phoenix9668/RFID_CC1101_433MHz_V2/Doc/PCB板载天线问题总结/微信图片_20250408164857.jpg

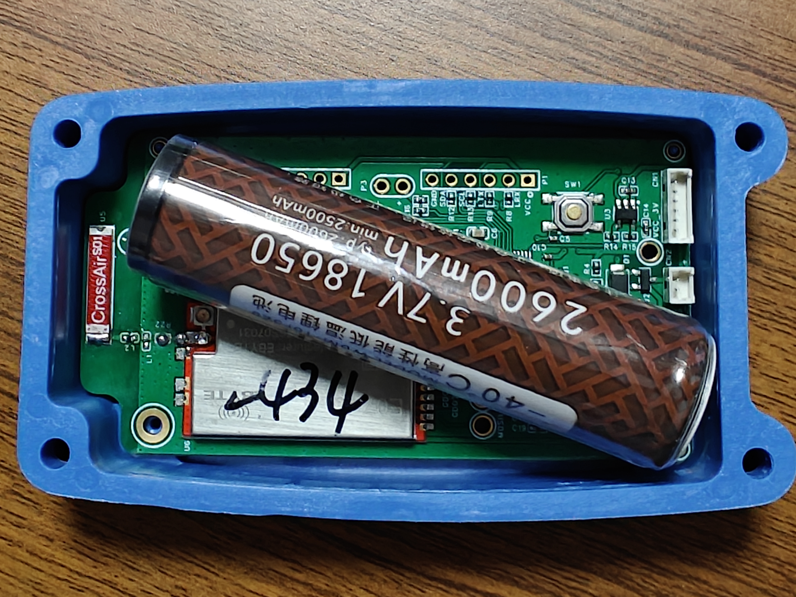
Doc/PCB板载天线问题总结/微信图片_20250408164857.jpg
