phoenix9668/RFID_CC1101_433MHz_V2/README.md

# RFID_CC1101_433MHz_V2
 upgrade of RFID_CC1101_433MHz program, use STM32L051C8, use HAL and LL Library, upgrade CC1101 Transceiver function (bytes upon 64).

## crc module configure as follow

Snipaste_2022-01-21_17-23-00

[](https://stackoverflow.com/questions/39646441/how-to-set-stm32-to-generate-standard-crc32)
