phoenix9668/RFID_CC1101_433MHz_V2/Tools/adxl362_pc/README.md

# ADXL362 PC algorithm runner

This harness compiles the production `Core/Src/adxl362_behavior.c` and
`Core/Inc/adxl362.h` directly. The firmware algorithm and its data structures
are not copied or modified. PC-only headers replace STM32 peripherals, and
`src/main.c` converts decoded CSV `x,y,z` samples back into the ADXL362 FIFO
byte format expected by `ADXL362FifoProcess()`.

## Data contract

- CSV header must contain `x`, `y`, and `z`.
- Values must be integer ADXL362 12-bit samples in `-2048..2047`.
- Sampling rate is 25 Hz.
- One firmware FIFO call consumes 150 samples (6 seconds / 900 bytes).
- An incomplete final 150-sample block is reported and ignored.
- CSV fields containing embedded commas are not supported by this small runner.

## Build and run

```sh
cd Tools/adxl362_pc
make
./build/adxl362_pc ../../Doc/data/chuanxi.csv result.csv
```

Use the firmware's `rfid_printf` diagnostics:

```sh
./build/adxl362_pc --verbose ../../Doc/data/chuanxi.csv result.csv
```

Build with AddressSanitizer and UndefinedBehaviorSanitizer:

```sh
make sanitize
./build-sanitize/adxl362_pc ../../Doc/data/chuanxi.csv result.csv
```

The output preserves each processed input row and appends a `behavior`
column. The behavior number is repeated for the corresponding 25 samples:

- `0`: initial delay
- `1`: rest
- `2`: ingestion
- `3`: movement
- `4`: climb
- `5`: ruminate
- `6`: other
- `7`: breath

## Windows PowerShell

With native MinGW-w64 GCC on PATH, run from the repository root:

```powershell
New-Item -ItemType Directory -Force build/adxl362-pc
gcc -std=c11 -O2 -Wall -Wextra -ITools/adxl362_pc/include -ICore/Inc -D_Original_Data_Algorithm=1 -DADXL362_PC_RUNNER=1 Tools/adxl362_pc/src/main.c Tools/adxl362_pc/src/pc_platform.c Core/Src/adxl362_behavior.c -lm -o build/adxl362-pc/adxl362_pc.exe
./build/adxl362-pc/adxl362_pc.exe Doc/data/chuanxi.csv build/adxl362-pc/chuanxi.csv
```

`pc_getline.h` supplies the line reader on Windows; POSIX builds continue using
the system `getline`. Some older MinGW runtimes cannot open non-ASCII argument
paths. Copy such fixtures to an ASCII filename under `build/`, verify the copy's
SHA256 matches the source, and pass that path to the runner.

Test empty input, line endings, long lines and a final line without a newline:

```sh
make test
```

Or, from the repository root in PowerShell after creating the build directory:

```powershell
gcc -std=c11 -Wall -Wextra -Werror -ITools/adxl362_pc/include Tools/adxl362_pc/tests/test_pc_getline.c -o build/adxl362-pc/test_pc_getline.exe
./build/adxl362-pc/test_pc_getline.exe build/adxl362-pc/test_pc_getline.tmp
```
