phoenix9668/RFID_CC1101_433MHz_V2/Drivers/ADI/no-OS/README.md

# Analog Devices no-OS Snapshot

Imported from `analogdevicesinc/no-OS` commit
`0c4ef5cd278555ba4d426b35f87f30102460361f`.

Vendored files:

- `drivers/accel/adxl362/adxl362.c`
- `drivers/accel/adxl362/adxl362.h`
- `include/no_os_spi.h`
- `include/no_os_alloc.h`

Project-specific compatibility implementations live in `Core/Src`:

- `no_os_spi_stm32l0.c`
- `no_os_alloc.c`
