phoenix9668/RFID_CC1101_433MHz_V2/Doc/Contracts/购销合同_RFID_CC1101_433MHz_V3.8(盖章).pdf

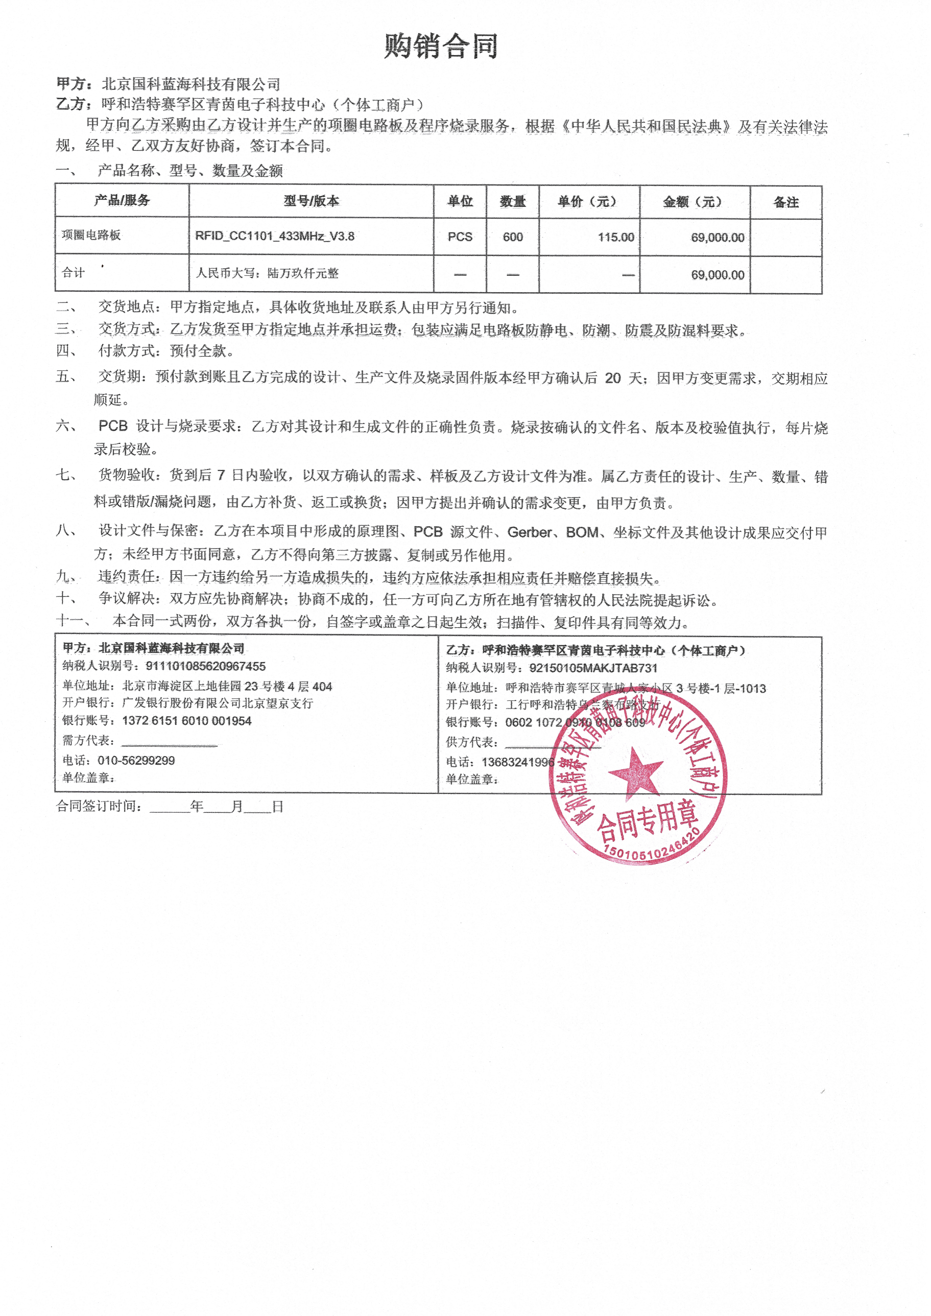
[picture p16: page 1]
