phoenix9668/RFID_CC1101_433MHz_V2/Doc/MATLAB/climb_analysis/视频3.png

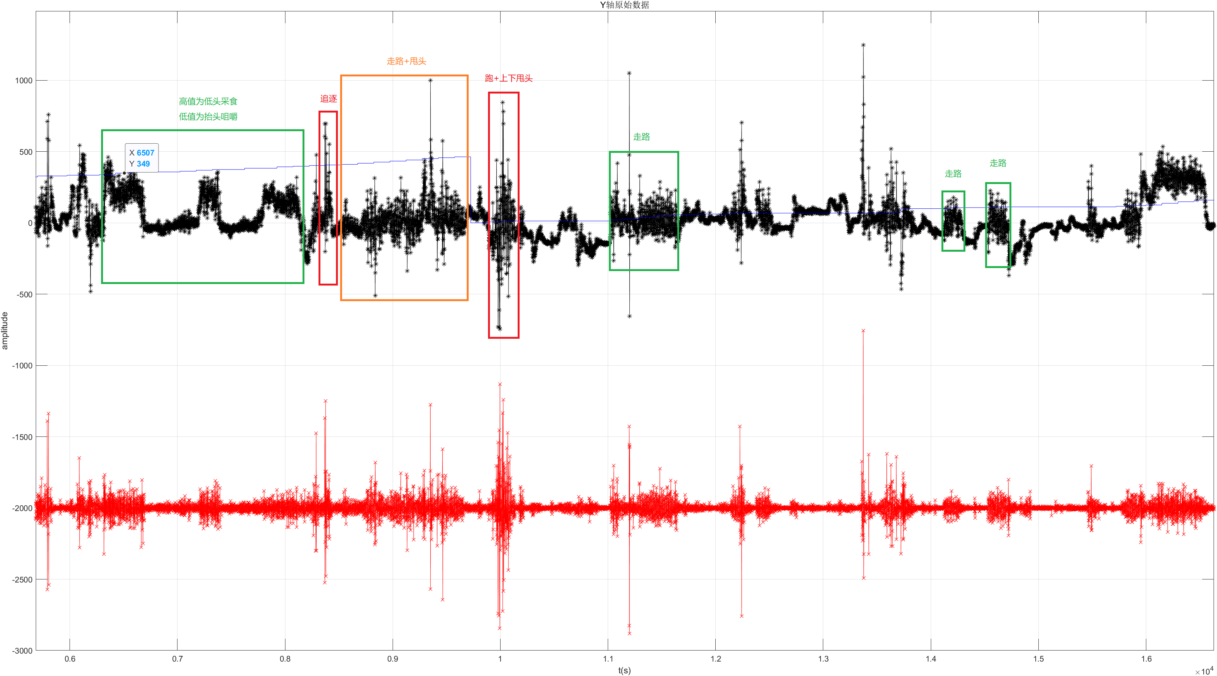
Doc/MATLAB/climb_analysis/视频3.png
