phoenix9668/RFID_CC1101_433MHz_V2/Doc/Picture/FIFOread总时序.PNG

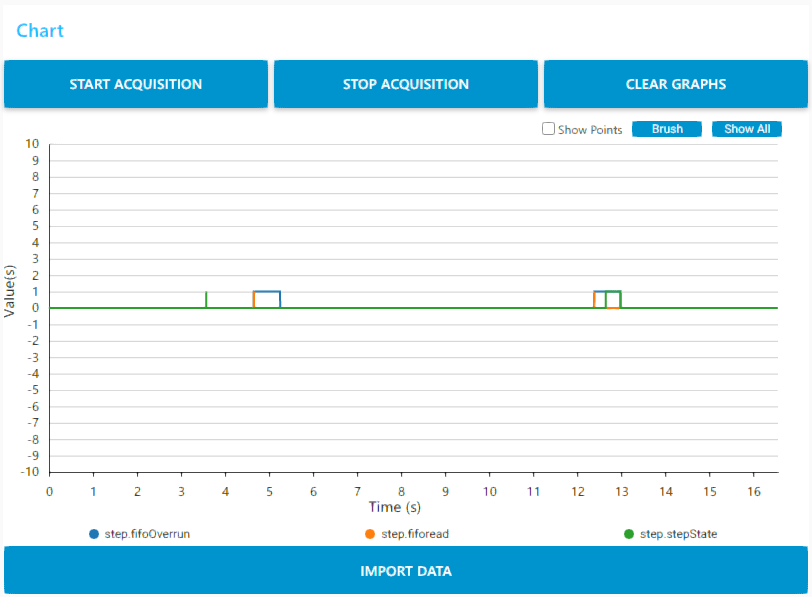
Doc/Picture/FIFOread总时序.PNG
