phoenix9668/RFID_CC1101_433MHz_V2/Doc/Picture/FIFOread总时序终点.png

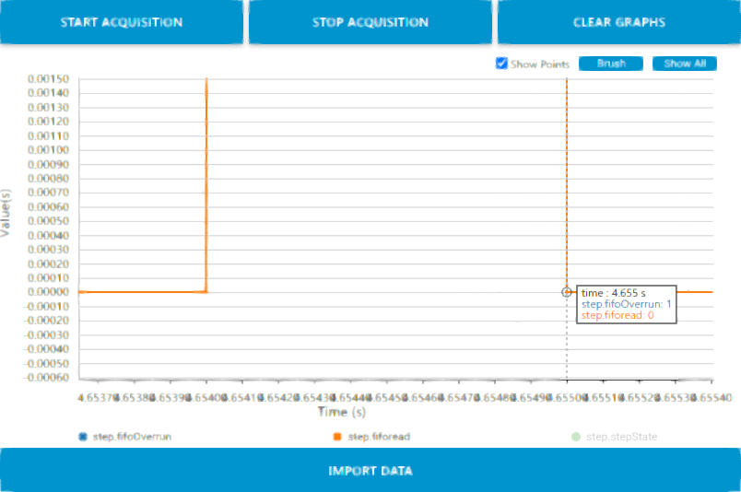
Doc/Picture/FIFOread总时序终点.png
