phoenix9668/RFID_CC1101_433MHz_V2/Doc/Picture/power.png

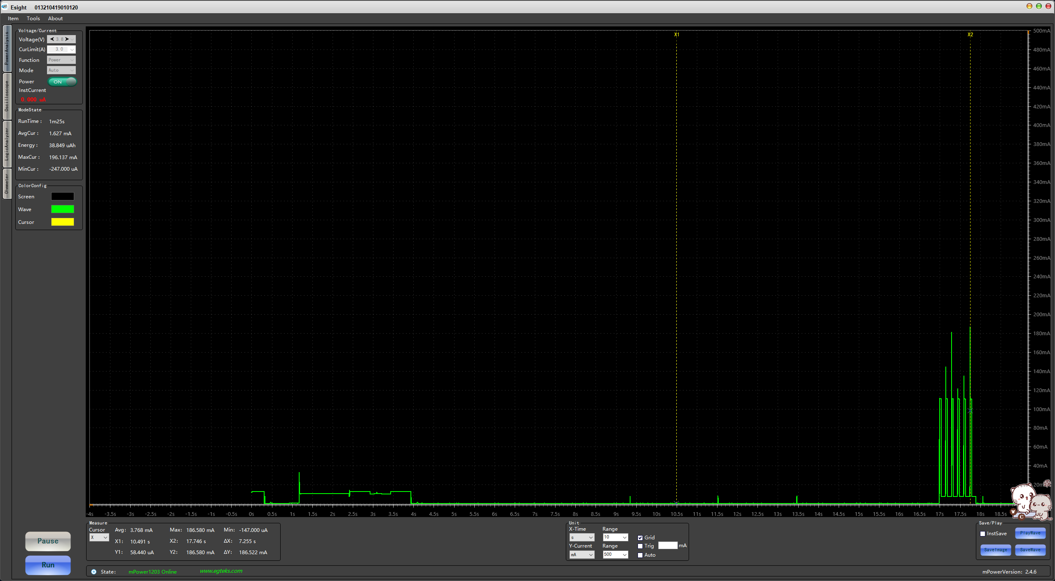
Doc/Picture/power.png
