phoenix9668/RFID_CC1101_433MHz_V2/Doc/Picture/tui1.png

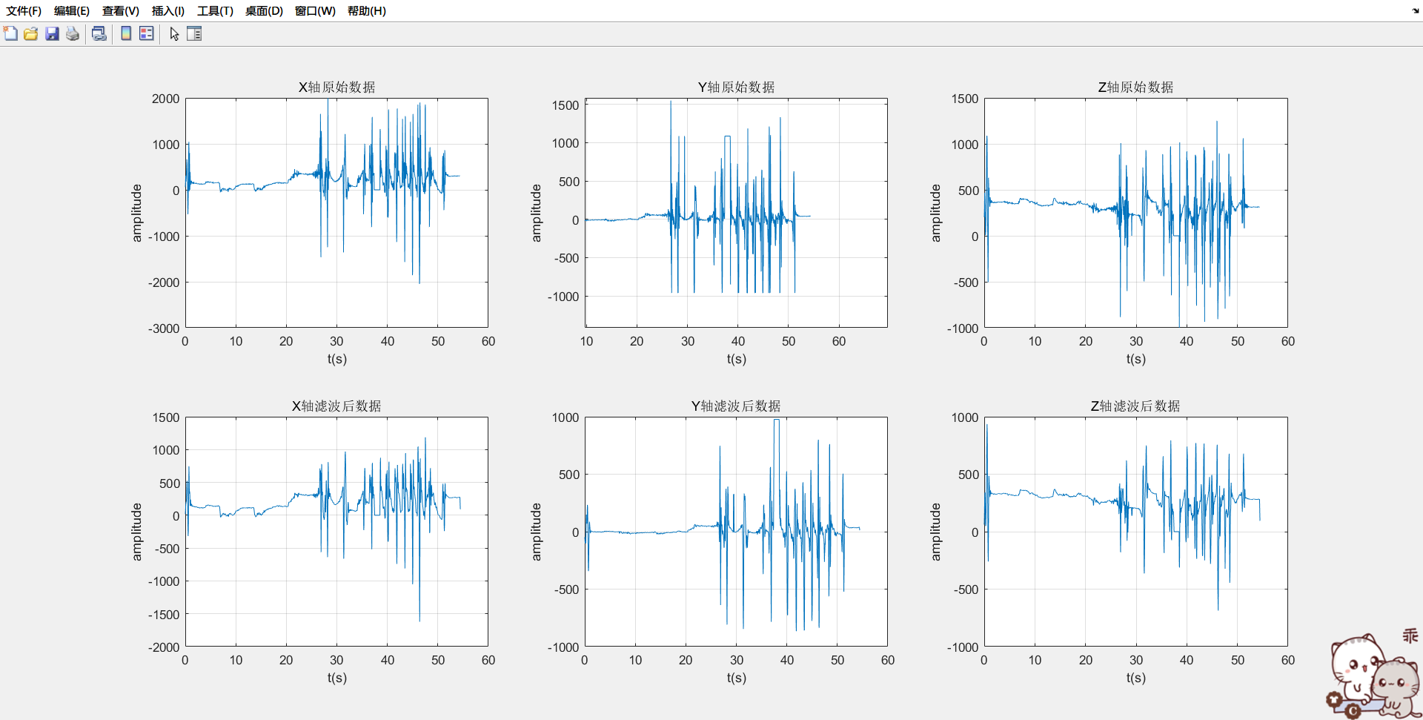
Doc/Picture/tui1.png
