phoenix9668/RFID_CC1101_433MHz_V2/Doc/Picture/发情算法计算时长.bmp

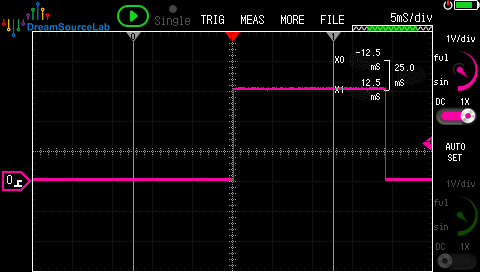
Doc/Picture/发情算法计算时长.bmp
