phoenix9668/RFID_CC1101_433MHz_V2/PCB/RFID_CC1101_433MHz_V3.8/BOM_RFID_CC1101_433MHz(2025.8.18)_RFID_CC1101_433MHz(2025.8.18)_2026-09-21.xlsx

No. | Quantity | Comment | Designator | Footprint | Value | Manufacturer Part | Manufacturer | Supplier Part | Supplier | LCSC Stock | LCSC Price
1 | 1 | BH-16340 | BT1 | BATTERY-SMD_16340
2 | 2 | 10pF | C1,C2 | C0402 | 10pF | CC0402FRNPO9BN100 | YAGEO(国巨) | C513681 | LCSC | 6097 | 0.0428
3 | 2 | 18pF | C3,C4 | C0402 | 18pF | CC0402FRNPO9BN180 | YAGEO(国巨) | C541431 | LCSC | 1167 | 0.0272
4 | 9 | 100nF | C5,C7,C9,C10,C11,C12,C17,C18,C21 | C0402 | 100nF | GRM155R71H104KE14D | muRata(村田) | C77020 | LCSC | 29641 | 0.0595
5 | 3 | 10uF | C6,C15,C16 | C0603 | 10uF | GRM188R61E106MA73D | muRata(村田) | C91606 | LCSC | 100662 | 0.5319
6 | 5 | 1uF | C8,C13,C14,C19,C20 | C0402 | 1uF | GRM155R6YA105KE11D | muRata(村田) | C361059 | LCSC | 1040 | 0.296
7 | 1 | HC-1.25-6A | CN1 | CONN-TH_6P-P1.25_HCTL_HC-1.25-6A |  | HC-1.25-6A | HCTL(华灿天禄) | C2845524 | LCSC | 1566 | 0.4415
8 | 1 | A1251WV-2P | CN2 | CONN-TH_2P-P1.25_A1251WV-2P |  | A1251WV-2P | CJT(长江连接器) | C225090 | LCSC
9 | 1 | SS24A | D1 | SMA_L4.2-W2.6-LS5.1-RD |  | SS24A | FUXINSEMI(富芯森美) | C842786 | LCSC | 366 | 0.135
10 | 1 | 27nH | L1 | L0402-RD | 27nH | LQG15HS27NJ02D | muRata(村田) | C12669 | LCSC | 3741 | 0.1162
11 | 1 | 47nH | L2 | L0402 | 47nH | LQG15HS47NJ02D | muRata(村田) | C97998 | LCSC | 1121 | 0.1504
12 | 2 | XL-1608SYGC-06 | LED1,LED2 | LED0603-RD_GREEN |  | XL-1608SYGC-06 | XINGLIGHT(成兴光) | C965805 | LCSC | 6263 | 0.0438
13 | 1 | XL-1608SURC-06 | LED3 | LED0603-RD_RED |  | XL-1608SURC-06 | XINGLIGHT(成兴光) | C965799 | LCSC | 41227 | 0.0231
14 | 1 | A2541HWV-6P | P1 | HDR-TH_6P-P2.54-V-F |  | A2541HWV-6P | CJT(长江连接器) | C2897443 | LCSC
15 | 1 | LBC0060B | P2 | LBC0060B
16 | 2 | S8050 | Q1,Q4 | SOT-23-3_L2.9-W1.3-P1.90-LS2.4-BR |  | S8050 | GOODWORK(固得沃克) | C909746 | LCSC | 2008 | 0.0726
17 | 2 | YJL2301C | Q2,Q3 | SOT-23-3_L2.9-W1.3-P1.90-LS2.4-BR |  | YJL2301C | YANGJIE(扬杰) | C699310 | LCSC | 143 | 0.2993
18 | 1 | 390Ω | R1 | R0402 | 390Ω | RC0402FR-07390RL | YAGEO(国巨) | C137997 | LCSC | 18559 | 0.0071
19 | 4 | 10kΩ | R2,R4,R12,R15 | R0402 | 10kΩ | RC0402FR-0710KL | YAGEO(国巨) | C60490 | LCSC | 54548 | 0.0197
20 | 3 | 1kΩ | R3,R14,R17 | R0402 | 1kΩ | RC0402FR-071KL | YAGEO(国巨) | C106235 | LCSC | 26273 | 0.0266
21 | 2 | 10MΩ | R5,R6 | R0402 | 10MΩ | RC0402FR-0710ML | YAGEO(国巨) | C138067 | LCSC | 0 | 0.0102
22 | 2 | 0Ω | R7,R18 | R0402 | 0Ω | RC0402FR-070RL | YAGEO(国巨) | C106231 | LCSC | 7794 | 0.0215
23 | 4 | 33Ω | R8,R9,R10,R11 | R0402 | 33Ω | RC0402FR-0733RL | YAGEO(国巨) | C138002 | LCSC | 80943 | 0.0217
24 | 1 | 1.2kΩ | R13 | R0402 | 1.2kΩ | RC0402FR-071K2L | YAGEO(国巨) | C138040 | LCSC | 2224 | 0.0248
25 | 1 | 100kΩ | R16 | R0402 | 100kΩ | RC0402FR-07100KL | YAGEO(国巨) | C60491 | LCSC | 83428 | 0.0161
26 | 1 | TS-1088R-02526 | SW2 | SW-SMD_L3.9-W3.0-P4.45 |  | TS-1088R-02526 | XUNPU(讯普) | C455281 | LCSC | 3137 | 0.4489
27 | 1 | M2铜柱 | TP1 | th_bd4.0-d2.0 |  | M2铜柱 |  | C9900004684 | LCSC
28 | 3 | M2铜柱 | TP2,TP3,TP4 | TH_BD4.0-D2.0_1 |  | M2铜柱 |  | C9900004684 | LCSC
29 | 16 | Test-Point | TP5,TP6,TP7,TP8,TP9,TP10,TP11,TP12,TP13,TP14,TP15,TP16,TP17,TP18,TP19,TP20 | Test-Point-0.5mm
30 | 1 | STM32L051C8T6 | U1 | LQFP-48_L7.0-W7.0-P0.50-LS9.0-BL |  | STM32L051C8T6 | ST(意法半导体) | C110878 | LCSC | 11621 | 10.47
31 | 1 | ADXL362BCCZ-RL | U2 | LGA-16_L3.0-W3.0-P0.50-BL |  | ADXL362BCCZ-RL | ADI(亚德诺) | C59641 | LCSC | 0 | 100.5648
32 | 1 | LP5907MFX-3.0/NOPB | U3 | SOT-23-5_L3.0-W1.7-P0.95-LS2.8-BL |  | LP5907MFX-3.0/NOPB | TI(德州仪器) | C475492 | LCSC | 2242 | 1.9955
33 | 1 | TP4056-42-ESOP8 | U4 | ESOP-8_L4.9-W3.9-P1.27-LS6.0-BL-EP |  | TP4056-42-ESOP8 | TOPPOWER(南京拓微) | C16581 | LCSC | 15205 | 1.1341
34 | 1 | CA-S01 | U5 | ANT-SMD_L15.0-W3.0 |  | CA-S01 |  | C2858568 | LCSC
35 | 1 | E07-433M20S | U6 | PE07-433M20S | Isupply(uA) = 2; Vin(V) = 2.1-3.6; Iout(max)(mA) = 100;
36 | 1 | 32.768kHz | X1 | CRYSTAL-SMD_L3.2-W1.5-1 | 32.768kHz | XKXGI-SUA-32.768K | YXC(扬兴晶振) | C5213671 | LCSC | 0 | 1.2209
37 | 1 | 12MHz | X2 | CRYSTAL-SMD_4P-L3.2-W2.5-BL | 12MHz | X322512MSB4SI | YXC(扬兴晶振) | C9002 | LCSC | 0 | 0.5831
