phoenix9668/RFID_CC1101_433MHz_V2/Doc/Purchase Contract/DTK LoRa模块采购.xls

LoRa Mesh
Description | Quantity | Purchasing Options | Cost | Total Cost | Necessary | Address | Purchasing Link
DTK LoRa模块 470M无线串口通信模块 SX1262自动中继Mesh-DRF1665 | 8 | 插针式（配转接线+胶棒天线） | 47.5 | 380 | 必备 | 寄往呼市办公室 | https://item.taobao.com/item.htm?id=623204594082&scene=taobao_shop
3.3V UART(TTL)转USB底板,USB适配板,DRF2658V20,送USB线 | 8 | 焊排母 | 20 | 160 | 必备 | 寄往呼市办公室 | https://item.taobao.com/item.htm?spm=2013.1.0.0.9b2136feWzbmSz&id=546741494746&scene=taobao_shop
USB转LoRa无线模块,470MHz 3km远距传输,Mesh网,自动中继,DRF2668 | 8 | 吸盘天线+导轨扣 | 104 | 832 | 必备 | 寄往呼市办公室 | https://item.taobao.com/item.htm?id=622913020311
4路485串口服务器转以太网网口通信modbus工业级通讯模块rs485转tcp/ip网关rj45 | 2 |  | 384.12 | 768.24 | 必备 | 寄往呼市办公室 | 709￥ HU006 mBgbehdGGq2￥ https://m.tb.cn/h.TKA2LcV 4路485串口服务器转以太网网口通信modbus工业级通讯模块rs485转tcp/ip网关rj45
Apple/苹果 Mac mini Apple M4 芯片 10 核中央处理器 10 核图形处理器 16GB 统一内存 256GB 固态硬盘 | 1 | 颜色分类：银色 | 4499 | 4499 | 必备 | 寄往呼市办公室 | https://detail.tmall.com/item.htm?id=848566645881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
433/470MHZ内置FPC天线433m弹簧天线lora模块pcb天线全向高增益 | 600 | 颜色分类：I款 433/470弹簧（25*5mm） 天线总长7.5cm 套餐类型：IPEX 1代 | 1 | 600 | 必备 | 寄往呼市办公室 | https://item.taobao.com/item.htm?_u=c2mr66eb6a0&id=626357509762&skuId=4611833274944
 |  |  |  | 7239.24
