phoenix9668/RFID_CC1101_433MHz_V2/Doc/Purchase Contract/RFID_CC1101_433MHz_V3.3(2024.3.26)项圈生产BOM(1000套).xls

RFID V3.3(1000套)
电池&太阳能板&NFC
Description | Quantity | U8编码 | Purchasing Options | Cost | Total Cost | Necessary | Address | Purchasing Link | 重要信息
伍宾 -40度 耐低温 18650锂电池 2600mAh | 1000 | 2022110402 | 单节原装电池加镍片+保护板 | 24.5 | 24500 | 必备 | 寄往组装工厂 | https://detail.tmall.com/item.htm?_u=t2dmg8j26111&id=607538305129&skuId=4609063750334 | 报北京国科蓝海科技有限公司，客服就知道了，加镍片和保护板的购买链接没有，需要沟通一下。 客服之前说数量为3000的订单单价可以降到24.5元
太阳能电池板 | 1050 | 2023071309 | 滴胶板 尺寸：42.6mm*74.6mm | 4 | 4200 | 必备 | 寄往组装工厂 |  | 深圳市晟阳光电有限公司报价
螺丝&端子&胶
卡夫特ab胶K-9761环氧树脂灌封胶透明耐高温超强粘接胶水晶滴胶 | 40 | 2023081116 |  | 168 | 6720 | 必备 | 寄往呼市办公室 | https://item.taobao.com/item.htm?id=19285626496&ns=1&abbucket=0 (https://item.taobao.com/item.htm?spm=a21n57.1.0.0.39e6523c60NNp7&id=19285626496&ns=1&abbucket=0)
A1251H-2P胶壳带端子带线 | 1100 | 20230713301 | 单头+15CM=150MM+2P+红黑 | 0.5 | 550 | 必备 | 寄往组装工厂 | https://item.taobao.com/item.htm?spm=a1z09.2.0.0.73992e8dQAu5Sz&id=633416872142&_u=f2mr66e5b6d | 购买时备注红黑
304十字圆头机丝M3*12 | 50 | 2023071302 | M3*12[100个] | 4.5 | 225 | 必备 | 寄往组装工厂 | https://detail.tmall.com/item.htm?_u=f2mr66e0c9d&id=637524754721&skuId=4742801506969
304十字圆头机丝M2*4 | 20 | 2023071303 | M2*4[100个] | 2.3 | 46 | 必备 | 寄往组装工厂 | https://detail.tmall.com/item.htm?_u=f2mr66e0c9d&id=637524754721&skuId=4742801506980
铜花母双通M3*8-4.2 | 50 | 2023071304 | M3*8-4.2 [100只]滚花螺母 | 5.1 | 255 | 必备 | 寄往组装工厂 | https://detail.tmall.com/item.htm?_u=f2mr66e18f4&id=534989268136&skuId=3192095447285
铜花母双通M2*3-3.5 | 20 | 2023071307 | M2*3-3.5 [100只]滚花螺母 | 3.5 | 70 | 必备 | 寄往组装工厂 | https://detail.tmall.com/item.htm?_u=f2mr66e18f4&id=534989268136&skuId=3192095447265
PCB电路板
RFID_CC1101_433MHz_V3.3(2023.4.10) | 1050 | 2023071310 | PCBA板卡 | 86 | 90300 | 必备 | 寄往组装工厂 |  | 由PCBA工厂报价，超过1000个应降价
 |  |  |  |  | 126866
