phoenix9668/RFID_CC1101_433MHz_V2/Doc/Purchase Contract/RFID_CC1101_433MHz_配件.xls

Sheet: 组装组件
RFID项圈
LibRef | Quantity | Comment | Description | Footprint | Cost | Total Cost | Address | Manufacturer
聚合物锂电池 | 100 | 204078,9600mAh,带1.25mm2P插头，具体型号为A1251H-XP-2P，插头正负极见图片 | 额定电压：3.7V 充电电压：4.2V 充电温度：-30°C~40°C 放电温度：-30°C~+60°C 存储温度：-20°C~+30°C 充电电流：标准充电：0.5C、快速充电：1.0C 标准充电方法：0.5C CC（恒流）充电至4.25V，再CV（恒压4.2V）充电直至充电电流0.05C 最大充电电流：1C 最大放电电流：1C 保护IC参数: 过充电保护电压4.20V±0.05V ，过放电保护电压2.7V±0.1V,充许最大电流3A。 | 20mm*40mm*78mm | 35 | 3500 | 寄往组装工厂 | https://item.taobao.com/item.htm?id=591965391710&tracelogww=ltckbburl
433MHz内置弹簧天线 | 100 | 银色（433M-弯头银） | 频率范围：423-443MHz 天线增益：1dBi 产品尺寸：37×Φ0.8mm 整体重量：1g | 37×Φ0.8mm | 0.7 | 70 | 寄往PCBA工厂 | https://detail.tmall.com/item.htm?id=619122427541&_u=q2mr66eb257&skuId=4369710013002
太阳能板 | 100 | 尺寸：90×62mm 电压：5V | 产品尺寸：90×62mm 电压：5V | 90×62mm | 4.95 | 495 | 寄往组装工厂 | 深圳市晟阳光电有限公司
 |  |  |  |  |  | 4065

Sheet: 组装配件
RFID项圈
LibRef | Quantity | Comment | Description | Footprint | Cost | Total Cost | Address | Manufacturer
3M白色双面强力泡棉胶带 | 1 | 10毫米宽*30米长 白色CIP66 | 3M CIP66白色双面强力泡棉胶带 双面胶 家居 装修装饰 广告 车用 办公 无痕 耐水 耐用 10毫米*30米 单卷装 | 1卷可生产300个项圈 | 36.5 | 36.5 | 寄往组装工厂 | https://item.m.jd.com/product/100003745226.html?ad_od=share&gx=RnExkGFaPWKKytRP--tzXzf50cz7g3Ye1Tk9
西卡玻璃胶 | 1 | 经典家用款透明一支 | 西卡（sika）玻璃胶 防水 防霉 厨卫窗户密封胶中性硅胶门窗马桶安装固定密封胶 Sikasil C 经典家用款透明一支 | 1支可生产200个项圈 | 42 | 42 | 寄往PCBA工厂 | https://item.m.jd.com/product/33308242329.html?ad_od=share&gx=RnExkGFaPWKKytRP--tzXzf50cz7g3Ye1Tk9
M3螺丝 | 14 | M3*30[30个] | 304不锈钢圆头自攻螺丝钉盘头十字木螺钉PA尖尾大头自攻钉 | 14袋可生产100个项圈 | 1.88 | 26.32 | 寄往PCBA工厂 | https://detail.tmall.com/item.htm?id=589962569524&spm=a1z09.2.0.0.4a8b2e8dtDsnyg&_u=q2mr66ee988
M1.7螺丝 | 3 | M1.7*6[100个] | 固万基304不锈钢十字圆头平尾自攻螺丝PB元头盘头螺钉 | 3袋可生产100个项圈 | 3.9 | 11.7 | 寄往PCBA工厂 | https://detail.tmall.com/item.htm?id=550539941898&spm=a1z09.2.0.0.4a8b2e8dtDsnyg&_u=q2mr66ead04
硅胶发泡圆条 | 1 | Φ1mm[100米整卷] | 硅胶发泡圆条 硅胶条密封条 海绵条1mm | 1卷可生产400个项圈 | 65 | 65 | 寄往PCBA工厂 | https://detail.tmall.com/item.htm?id=641879605112&_u=q2mr66e72c8&skuId=4790045611285
 |  |  |  |  |  | 181.52

Sheet: 组装工具
RFID项圈
LibRef | Quantity | Comment | Description | Footprint | Cost | Total Cost | Address | Manufacturer
PCB烧录夹 | 5 | 排针数：4P 排数：单排 间距：2.54 线长：30cm |  |  | 22.8 | 114 | 寄往组装工厂 | https://item.taobao.com/item.htm?spm=a1z09.2.0.0.5b662e8dsQJ2YR&id=596443705345&_u=f2mr66e55d9
 | 5 | 排针数：3P 排数：单排 间距：2.54 线长：30cm |  |  | 21.85 | 109.25
ST-LINK转接板 | 5 | 单独转接板 |  |  | 7 | 35 | 寄往组装工厂 | https://item.taobao.com/item.htm?id=602610376296&ns=1&abbucket=12 (https://item.taobao.com/item.htm?spm=a230r.1.14.16.5ab8e0ac4hJ2LO&id=602610376296&ns=1&abbucket=12)
USB转TTL | 5 | Arduino FTDI Basic程序下载器USB转TTL FT232RL配线 |  |  | 40 | 200 | 寄往组装工厂 | https://item.taobao.com/item.htm?spm=a1z09.2.0.0.44a02e8dSHHM2i&id=557247591881&_u=g2mr66e801b
ST-LINKV2 | 5 | ST-LINKV2 | STM8 STM32 调试器 仿真器 烧录器 下载器 |  | 118 | 590 | 寄往组装工厂 | https://detail.tmall.com/item.htm?id=586228472629&rn=6515de3d6b5987d909be310a6f003b58&abbucket=20
 |  |  |  |  |  | 1048.25
