phoenix9668/RFID_CC1101_433MHz_V2/Doc/Purchase Contract/带镍片18650耐低温锂电池(2023.4.26).xls

RFID
传感器及配件
Description | Quantity | Purchasing Options | Cost | Total Cost | Necessary | Address | Purchasing Link | 重要信息
伍宾 -40度 耐低温 18650锂电池 2600mAh | 20 | 单节原装电池加镍片+保护板 | 30 | 600 | 必备 | 寄往呼市办公室 | https://detail.tmall.com/item.htm?_u=t2dmg8j26111&id=607538305129&skuId=4609063750334 | 报北京国科蓝海科技有限公司，客服就知道了，加镍片和保护板的购买链接没有，需要沟通一下。
Arduino Nano 33 BLE SENSE开发板意大利原装单片机官方ABX00069 | 1 |  | 369 | 369 | 必备 | 寄往呼市办公室 | https://item.taobao.com/item.htm?spm=a1z0d.6639537/tb.1997196601.89.24987484ej4yNt&id=673844031500
 |  |  |  | 969
