phoenix9668/RFID_CC1101_433MHz_V2/Doc/Purchase Contract/环氧胶和NFC(2023.7.12) .xls

RFID
传感器及配件
Description | Quantity | Purchasing Options | Cost | Total Cost | Necessary | Address | Purchasing Link | 重要信息
卡夫特ab胶K-9761环氧树脂灌封胶透明耐高温超强粘接胶水晶滴胶 | 20 |  | 168 | 3360 | 必备 | 寄往呼市办公室 | https://item.taobao.com/item.htm?id=19285626496&ns=1&abbucket=0 (https://item.taobao.com/item.htm?spm=a21n57.1.0.0.39e6523c60NNp7&id=19285626496&ns=1&abbucket=0)
NFC芯片贴 | 6 | 215钱币卡 100张 | 61 | 366 | 必备 | 寄往呼市办公室 | https://detail.tmall.com/item.htm?id=692753398538&skuId=5092112987542
PCB烧录夹 | 5 | 针数：6P/6针 排数：单排 颜色分类：2.54mm | 22.8 | 114 | 必备 | 寄往呼市办公室 | https://item.taobao.com/item.htm?spm=a1z0d.7625083.1998302264.6.5c5f4e69JU0Rdv&id=675131874366
ST-LINK转接板 | 5 | 转接板+7根转接线 | 17.6 | 88 | 必备 | 寄往呼市办公室 | https://item.taobao.com/item.htm?id=602610376296&ns=1&abbucket=12 (https://item.taobao.com/item.htm?spm=a230r.1.14.16.5ab8e0ac4hJ2LO&id=602610376296&ns=1&abbucket=12)
USB转TTL | 5 | Arduino FTDI Basic程序下载器 配线 | 40 | 200 | 必备 | 寄往呼市办公室 | https://item.taobao.com/item.htm?spm=a1z09.2.0.0.44a02e8dSHHM2i&id=557247591881&_u=g2mr66e801b
ST-LINKV2 | 5 | ST-LINK V2 STM32 STM8 STLINK V2仿真器调试器下载器编程烧录器 | 118 | 590 | 必备 | 寄往呼市办公室 | https://detail.tmall.com/item.htm?abbucket=20&id=586228472629&rn=6515de3d6b5987d909be310a6f003b58
 |  |  |  | 4718
