phoenix9668/RFID_CC1101_433MHz_V2/Doc/Purchase Contract/RFID_CC1101_433MHz_V3.3(2023.11.10)项圈生产BOM.xls

RFID V3.3(500套)
电池&太阳能板&NFC
Description | Quantity | Purchasing Options | Cost | Total Cost | Necessary | Address | Purchasing Link | 重要信息
伍宾 -40度 耐低温 18650锂电池 2600mAh | 500 | 单节原装电池加镍片+保护板 | 24.5 | 12250 | 必备 | 寄往组装工厂 | https://detail.tmall.com/item.htm?_u=t2dmg8j26111&id=607538305129&skuId=4609063750334 | 报北京国科蓝海科技有限公司，客服就知道了，加镍片和保护板的购买链接没有，需要沟通一下。 客服之前说数量为3000的订单单价可以降到24.5元
NFC芯片贴 | 500 |  | 1.7 | 850 | 必备 | 寄往组装工厂
太阳能电池板 | 520 | 滴胶板 尺寸：42.6mm*74.6mm | 4 | 2080 | 必备 | 寄往组装工厂 |  | 深圳市晟阳光电有限公司报价
螺丝&端子&胶
卡夫特ab胶K-9761环氧树脂灌封胶透明耐高温超强粘接胶水晶滴胶 | 20 |  | 168 | 3360 | 必备 | 寄往呼市办公室 | https://item.taobao.com/item.htm?id=19285626496&ns=1&abbucket=0 (https://item.taobao.com/item.htm?spm=a21n57.1.0.0.39e6523c60NNp7&id=19285626496&ns=1&abbucket=0)
A1251H-2P胶壳带端子带线 | 550 | 单头+15CM=150MM+2P+红黑 | 0.5 | 275 | 必备 | 寄往组装工厂 | https://item.taobao.com/item.htm?spm=a1z09.2.0.0.73992e8dQAu5Sz&id=633416872142&_u=f2mr66e5b6d | 购买时备注红黑，如右图
304十字圆头机丝M3*12 | 25 | M3*12[100个] | 4.5 | 112.5 | 必备 | 寄往组装工厂 | https://detail.tmall.com/item.htm?_u=f2mr66e0c9d&id=637524754721&skuId=4742801506969
304十字圆头机丝M2*4 | 10 | M2*4[100个] | 2.3 | 23 | 必备 | 寄往组装工厂 | https://detail.tmall.com/item.htm?_u=f2mr66e0c9d&id=637524754721&skuId=4742801506980
铜花母双通M3*8-4.2 | 25 | M3*8-4.2 [100只]滚花螺母 | 5.1 | 127.5 | 必备 | 寄往组装工厂 | https://detail.tmall.com/item.htm?_u=f2mr66e18f4&id=534989268136&skuId=3192095447285
铜花母双通M2*3-3.5 | 10 | M2*3-3.5 [100只]滚花螺母 | 3.5 | 35 | 必备 | 寄往组装工厂 | https://detail.tmall.com/item.htm?_u=f2mr66e18f4&id=534989268136&skuId=3192095447265
PCB电路板
RFID_CC1101_433MHz_V3.3(2023.4.10) | 500 | PCBA板卡 | 86 | 43000 | 必备 | 寄往组装工厂 |  | 由PCBA工厂报价
烧录程序工具
PCB烧录夹 | 5 | 针数：6P/6针 排数：单排 颜色分类：2.54mm | 22.8 | 114 | 必备 | 寄往呼市办公室 | https://item.taobao.com/item.htm?spm=a1z0d.7625083.1998302264.6.5c5f4e69JU0Rdv&id=675131874366
ST-LINK转接板 | 5 | 转接板+7根转接线 | 17.6 | 88 | 必备 | 寄往呼市办公室 | https://item.taobao.com/item.htm?id=602610376296&ns=1&abbucket=12 (https://item.taobao.com/item.htm?spm=a230r.1.14.16.5ab8e0ac4hJ2LO&id=602610376296&ns=1&abbucket=12)
USB转TTL | 5 | Arduino FTDI Basic程序下载器 配线 | 40 | 200 | 必备 | 寄往呼市办公室 | https://item.taobao.com/item.htm?spm=a1z09.2.0.0.44a02e8dSHHM2i&id=557247591881&_u=g2mr66e801b
ST-LINKV2 | 5 | ST-LINK V2 STM32 STM8 STLINK V2仿真器调试器下载器编程烧录器 | 118 | 590 | 必备 | 寄往呼市办公室 | https://detail.tmall.com/item.htm?abbucket=20&id=586228472629&rn=6515de3d6b5987d909be310a6f003b58
壳体&织带
壳体 | 500 |  | 40 | 20000 | 必备 | 寄往组装工厂 |  | 由壳体工厂报价
织带 | 500 |  | 16.5 | 8250 | 必备 | 寄往组装工厂 |  | 由织带工厂报价
磁吸
壳体 | 500 |  | 7 | 3500 | 必备 | 寄往组装工厂 |  | 由磁吸工厂报价
 |  |  |  | 94855
