phoenix9668/RFID_CC1101_433MHz_V2/Doc/Purchase Contract/3D打印机(2022.11.18).xls

RFID
传感器及配件
Description | Quantity | Purchasing Options | Cost | Total Cost | Necessary | Address | Purchasing Link | 重要信息
乐积iX 3D打印机 | 1 | 套餐5 散件+工具+4卷料 | 1380 | 1380 | 必备 | 寄往内蒙古自治区锡林郭勒盟苏尼特右旗赛罕塔拉镇白音小区东区8号楼一单元二楼 | https://item.taobao.com/item.htm?spm=a1z0d.6639537/tb.1997196601.4.68d47484i8Qbgy&id=657898873613
电线剥皮钳(0.2～0.8mm) | 1 | (0.2～0.8mm) | 64 | 64 | 必备 | 寄往内蒙古自治区锡林郭勒盟苏尼特右旗赛罕塔拉镇白音小区东区9号楼一单元二楼 | https://item.jd.com/618280.html
焊锡丝 | 1 |  | 37.05 | 37.05 | 必备 | 寄往内蒙古自治区锡林郭勒盟苏尼特右旗赛罕塔拉镇白音小区东区10号楼一单元二楼 | https://item.jd.com/100007843875.html
 |  |  |  | 1481.05
