phoenix9668/RFID_CC1101_433MHz_V2/Doc/Supplier Contract/dzfp_25512000000104520016_北京国科诚泰农牧设备有限公司_20250507153950.pdf

# 电子发票（增值税专用发票） 发票号码：

开票日期：

购
买
方
信
息

统一社会信用代码/纳税人识别号：

销
售
方
信
息

统一社会信用代码/纳税人识别号：

名称： | 名称：
项目名称 | 规格型号 | 单 位 | 数 量 | 单 价 | 金 额 | 税率/征收率 | 税 额
合 | 计
价税合计（大写） | 壹万零柒佰伍拾圆整 ¥10750.00 （小写）

备 注

开票人：

25512000000104520016

2025年 05月 07日

北 京国科诚泰农牧设备有限公司

91110115677438311R

成都亿佰特电子科技有限公司

91510100594693114G

¥9513.27 | ¥1236.73

吴学会

*通信传输设备*无线模块 E07-433M20S | 个 | 500 19.0265486725664 | 9513.27 | 13% | 1236.73
