phoenix9668/RFID_CC1101_433MHz_V2/Doc/Supplier Contract/亿佰特 2025-05-07 15.25.pdf

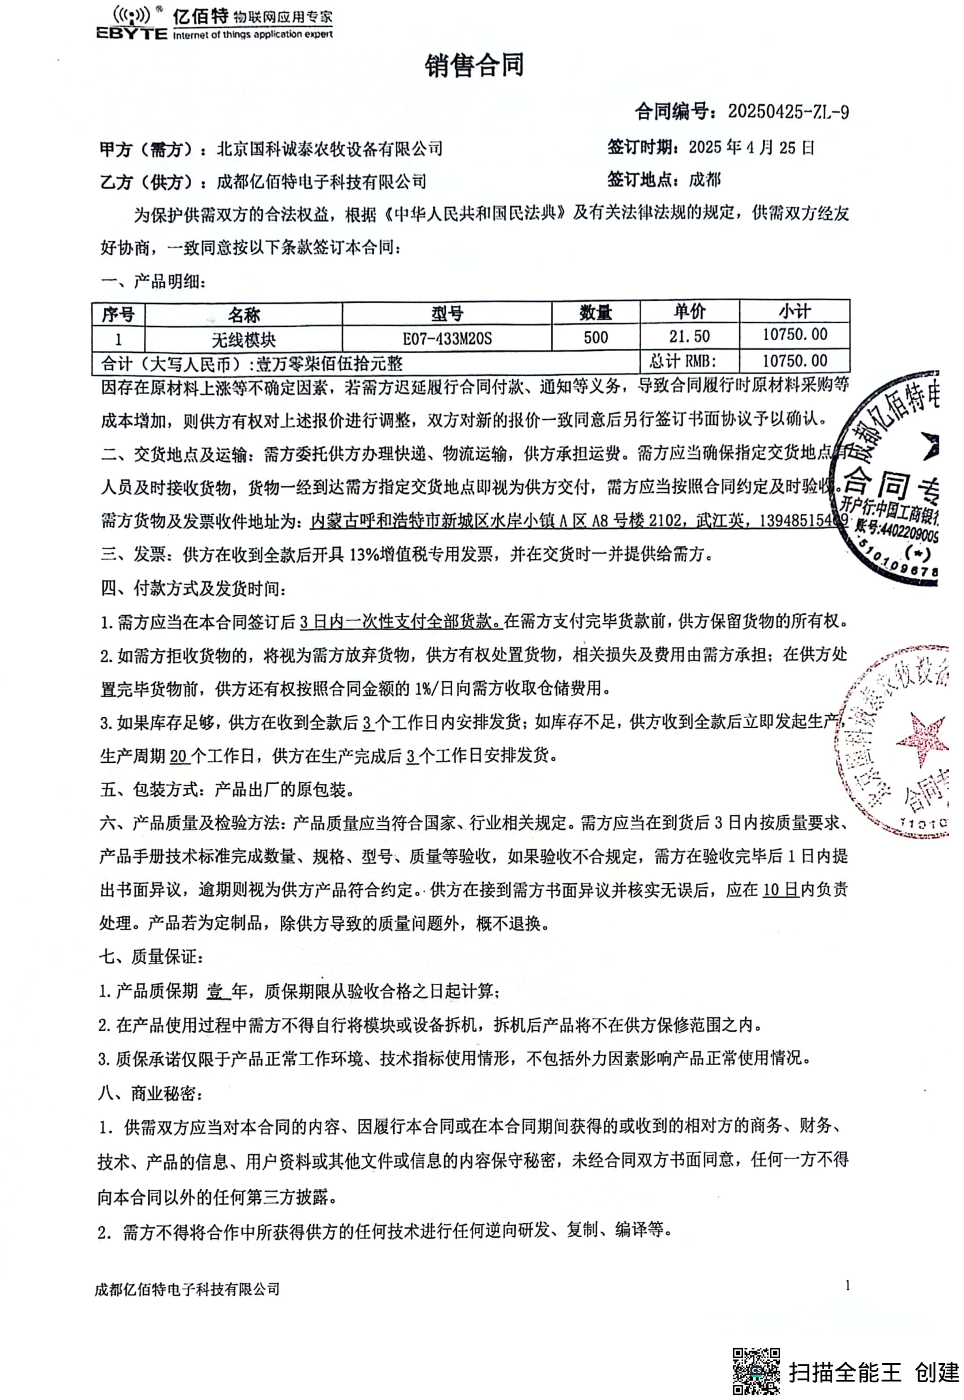
[picture p29: page 1]

扫描全能王 创建 (https://v3.camscanner.com/user/download)

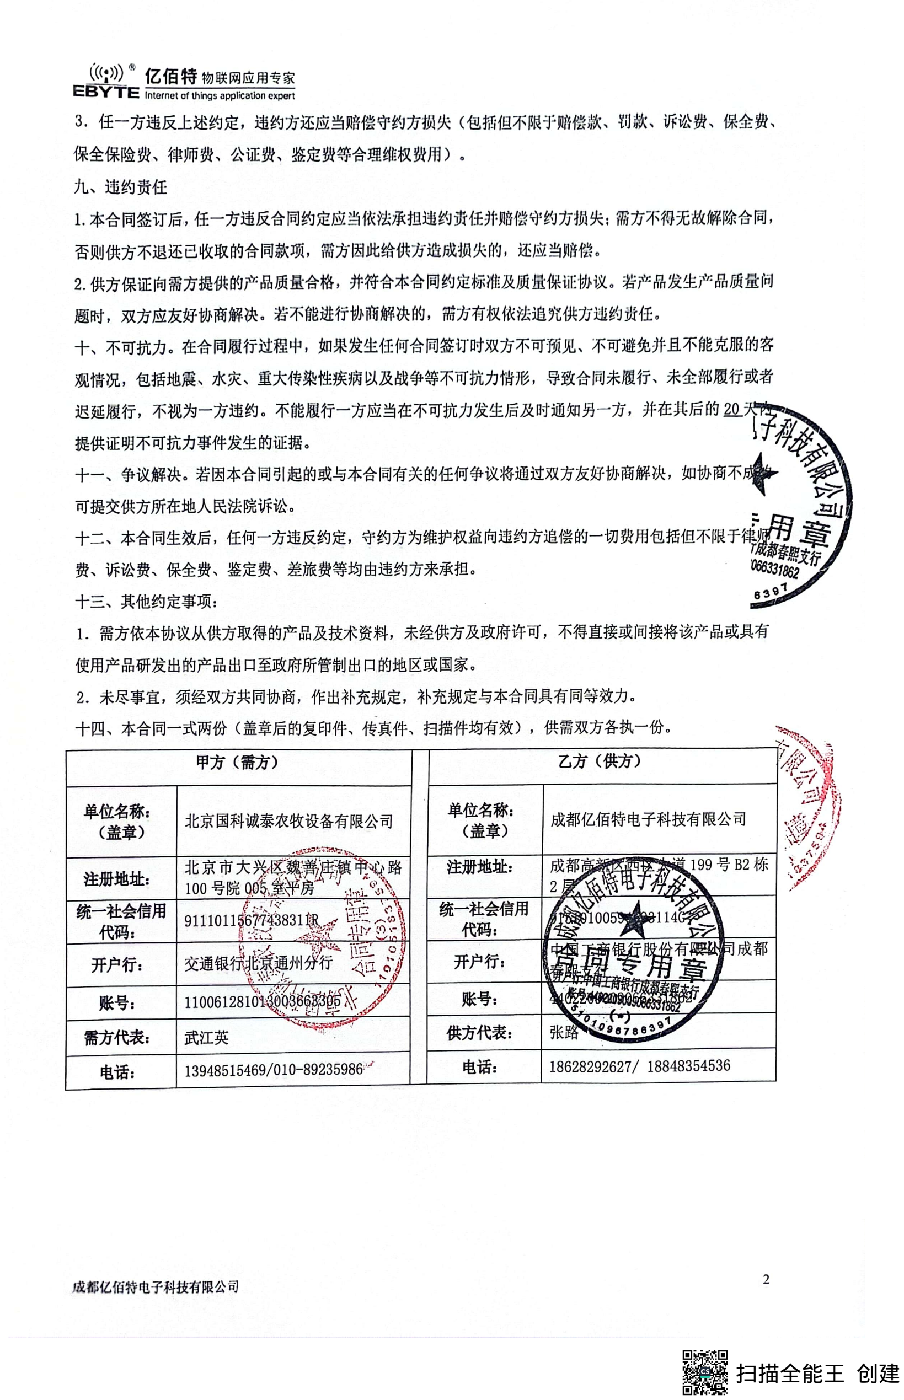
[picture p30: page 2]

扫描全能王 创建 (https://v3.camscanner.com/user/download)
