phoenix9668/RFID_CC1101_433MHz_V2/Doc/Supplier Contract/合同20260908-QK-1_盖章回传.pdf

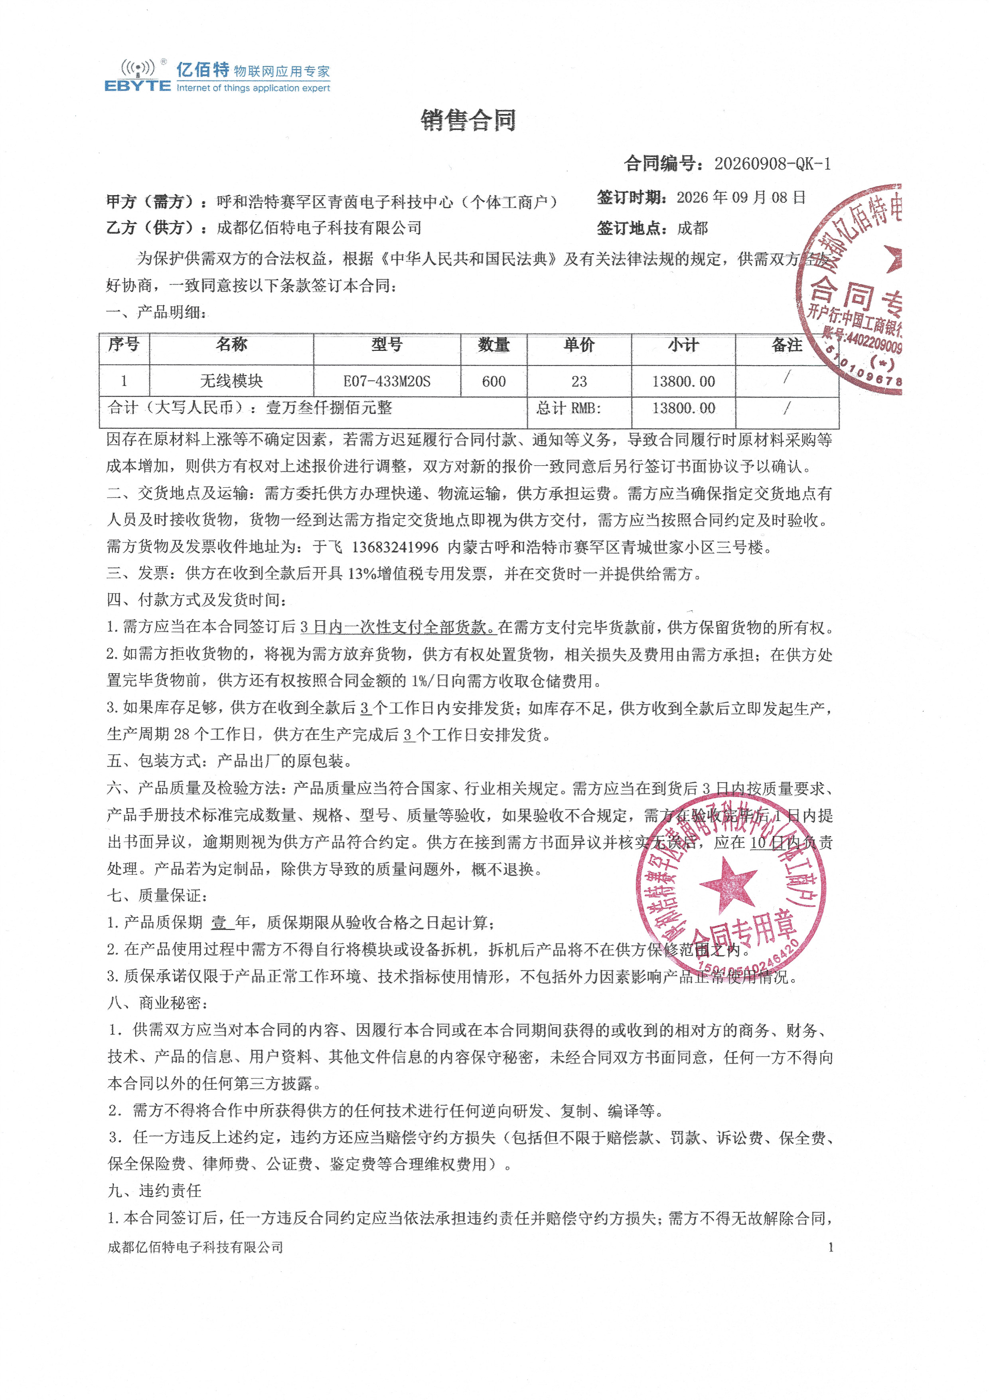
[picture p31: page 1]
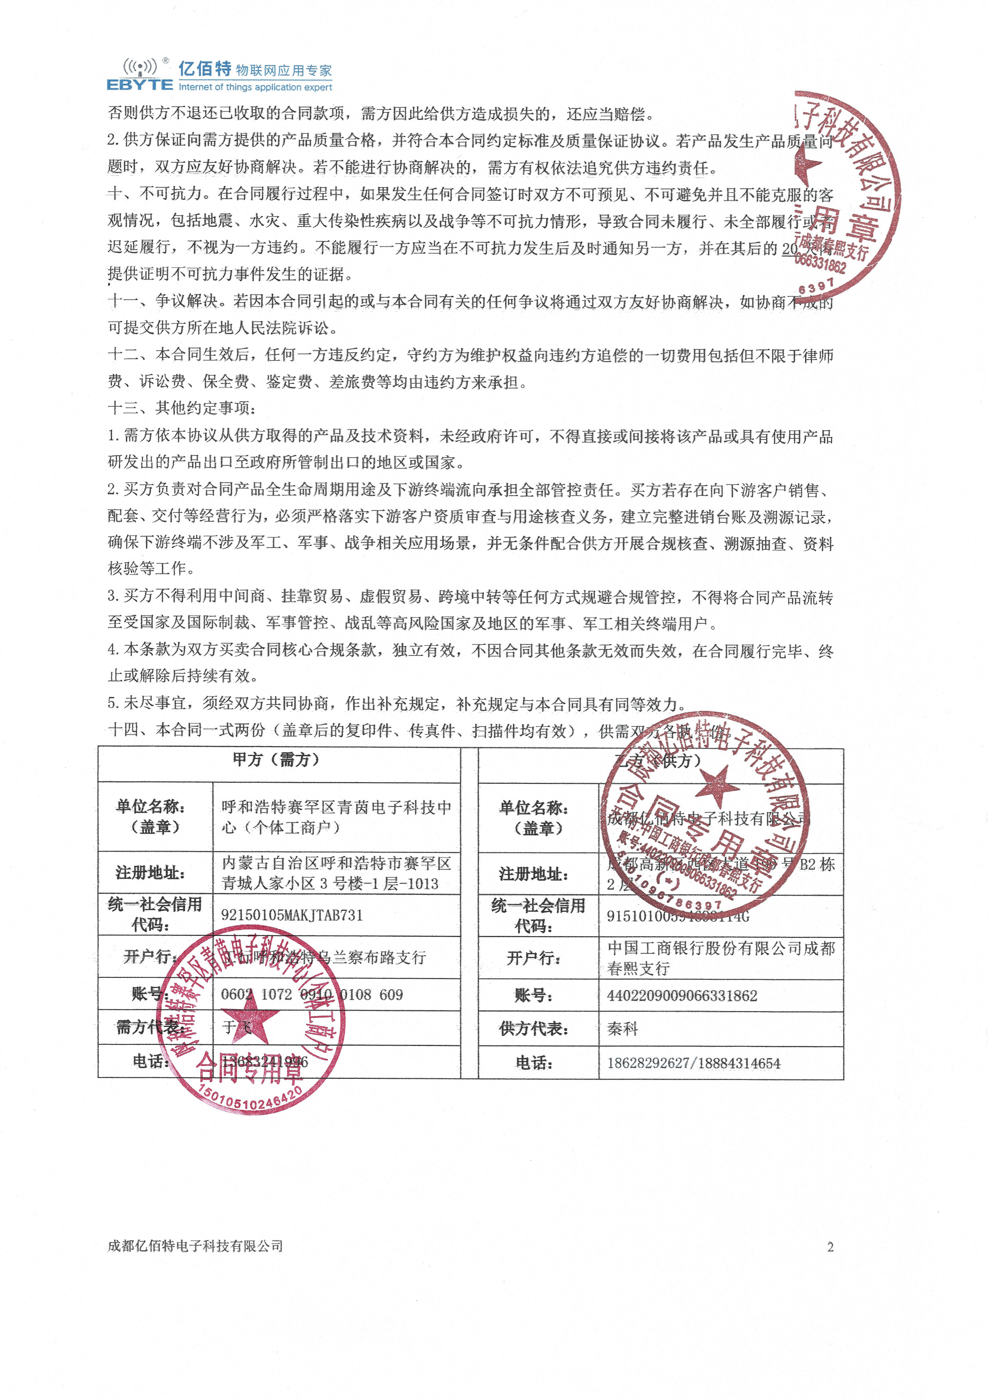
[picture p32: page 2]
