phoenix9668/RFID_CC1101_433MHz_V2/Doc/Purchase Contract/供货合同-北京国科诚泰农牧设备有限公司20250425.pdf

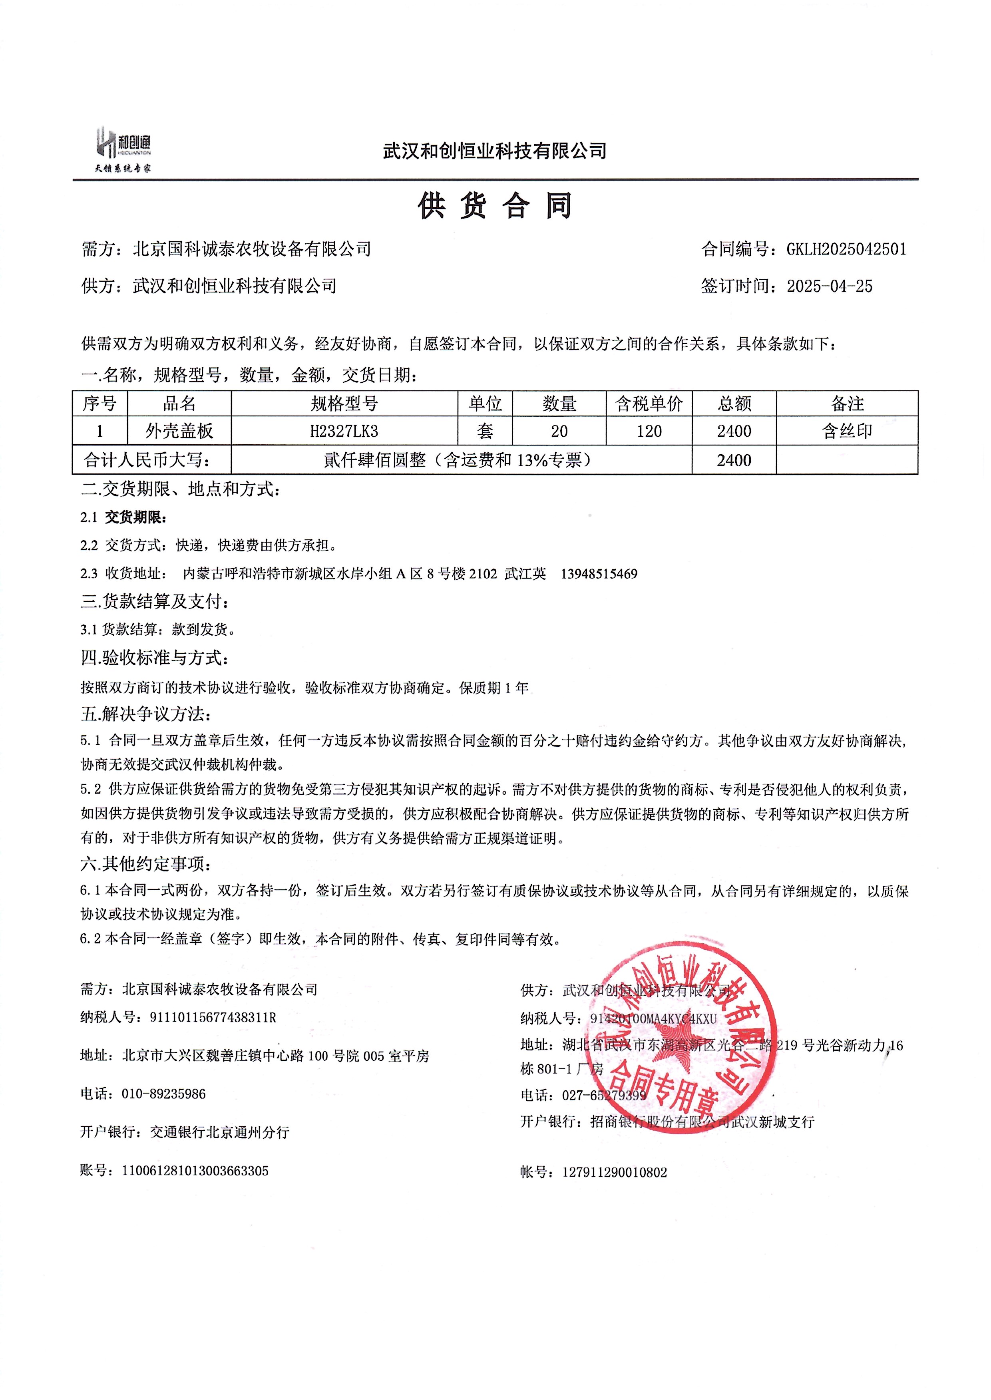
[picture p33: page 1]
