phoenix9668/RFID_CC1101_433MHz_V2/Doc/Purchase Contract/1_联保-国科购销合同(2024.4.1).pdf

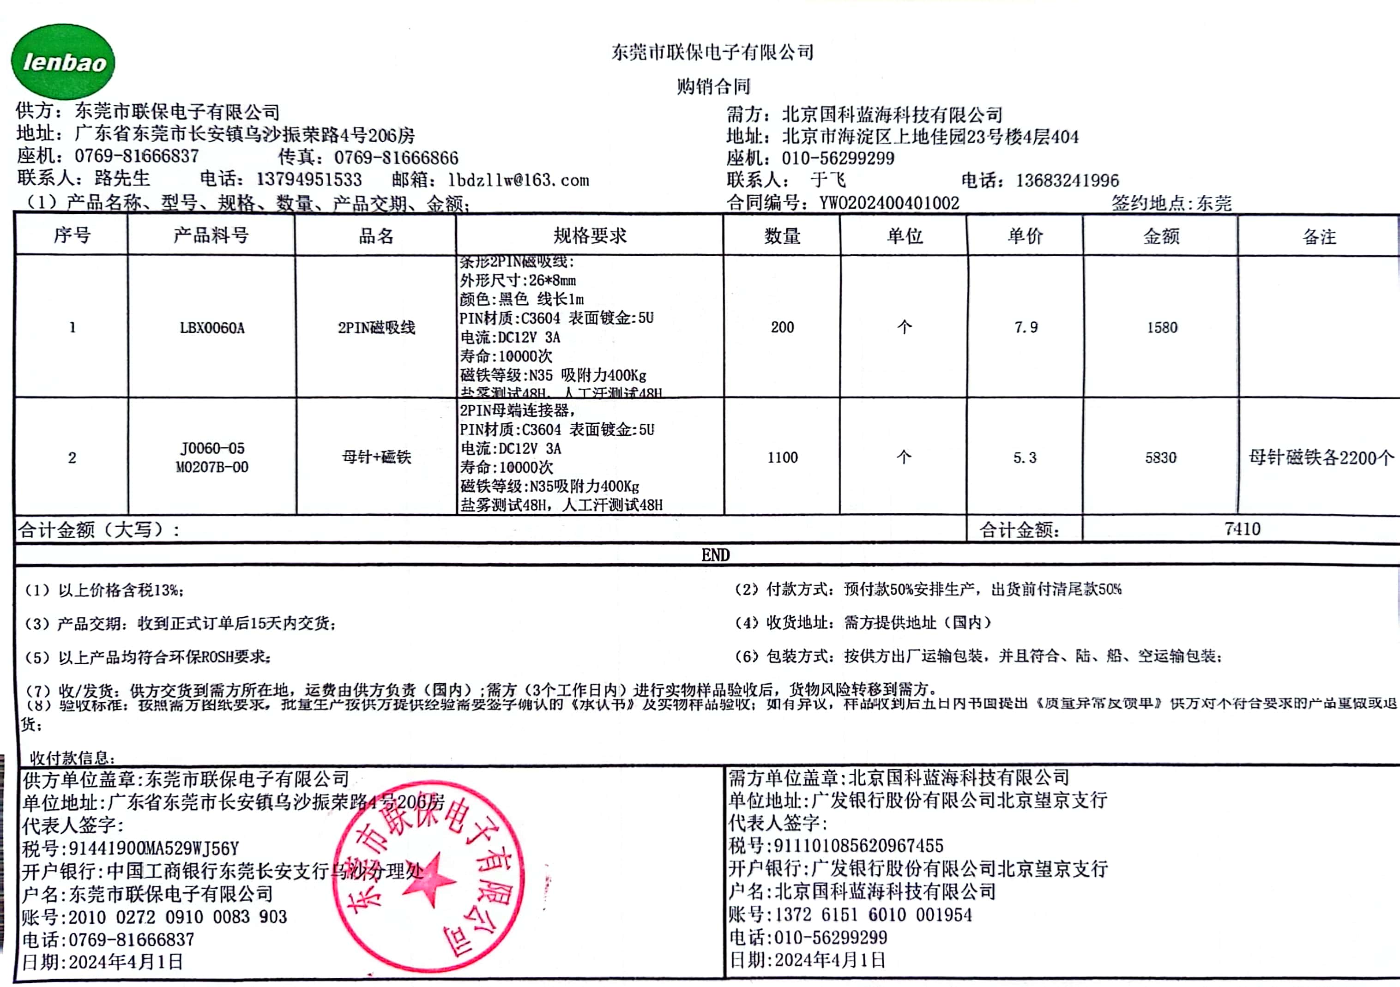
[picture p34: page 1]
