phoenix9668/RFID_CC1101_433MHz_V2/Doc/Purchase Contract/联保-国科购销合同（2023.9.18）.pdf

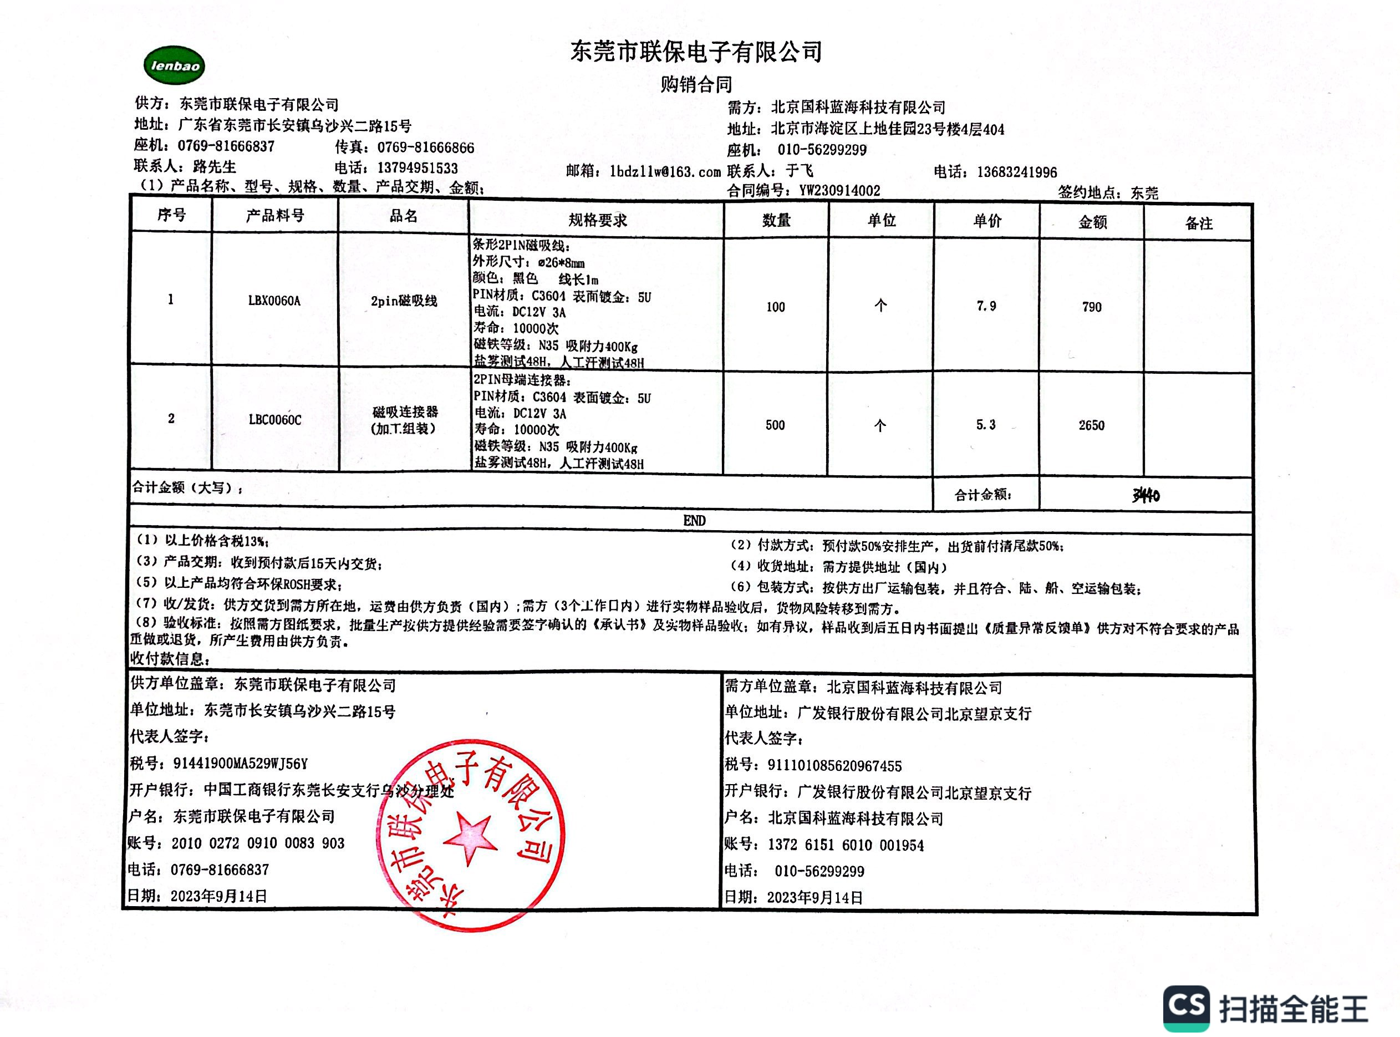
[picture p35: page 1]
