phoenix9668/RFID_CC1101_433MHz_V2/Doc/Purchase Contract/20230510-北京国科蓝海科技-S01天线匹配报告.pdf

# 贴片天线匹配调试报告

2023

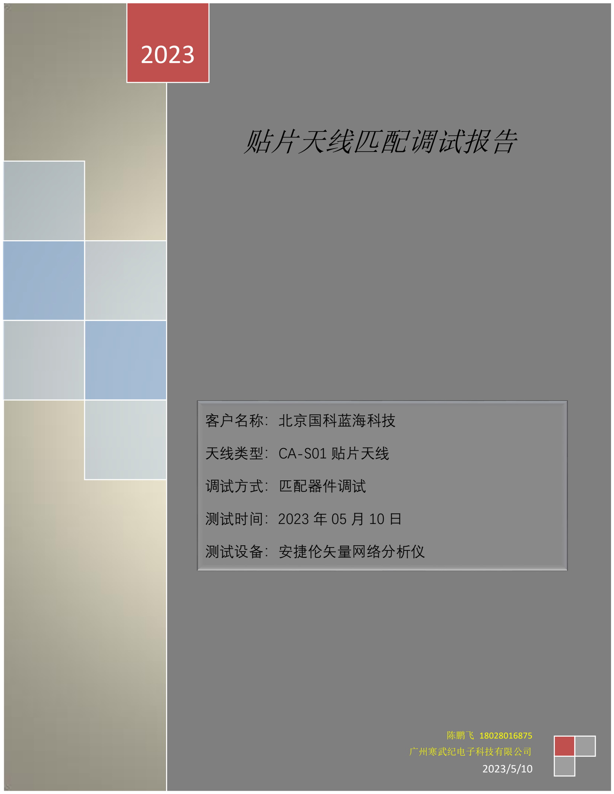
[picture p39: page 1]

陈鹏飞 18028016875
广州寒武纪电子科技有限公司
2023/5/10

## 客户名称：北京国科蓝海科技

## 天线类型：CA-S01 贴片天线

## 调试方式：匹配器件调试

## 测试时间：2023 年 05 月 10 日

## 测试设备：安捷伦矢量网络分析仪

广州寒武纪电子科技有限公司 联系人：陈鹏飞 18028016875
目录

# 一 内置天线测试环境及匹配网络 1 该产品的调试测试环境如下，为整机测试

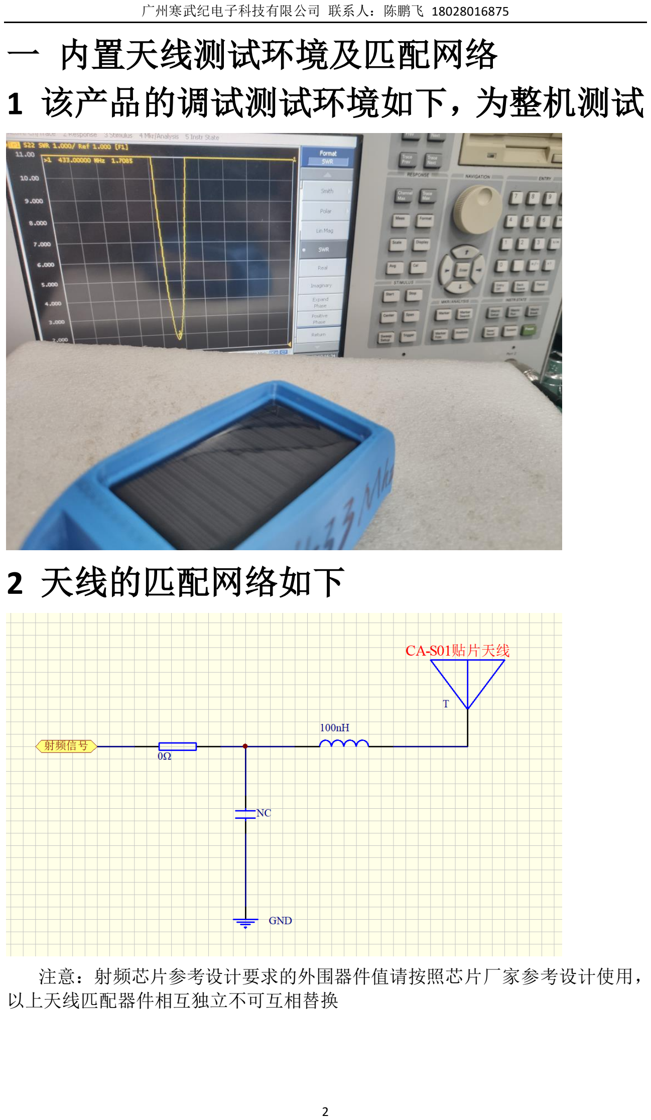
[picture p40: page 3]

# 2 天线的匹配网络如下

注意：射频芯片参考设计要求的外围器件值请按照芯片厂家参考设计使用， 以上天线匹配器件相互独立不可互相替换

# 二 实测结果 天线驻波比

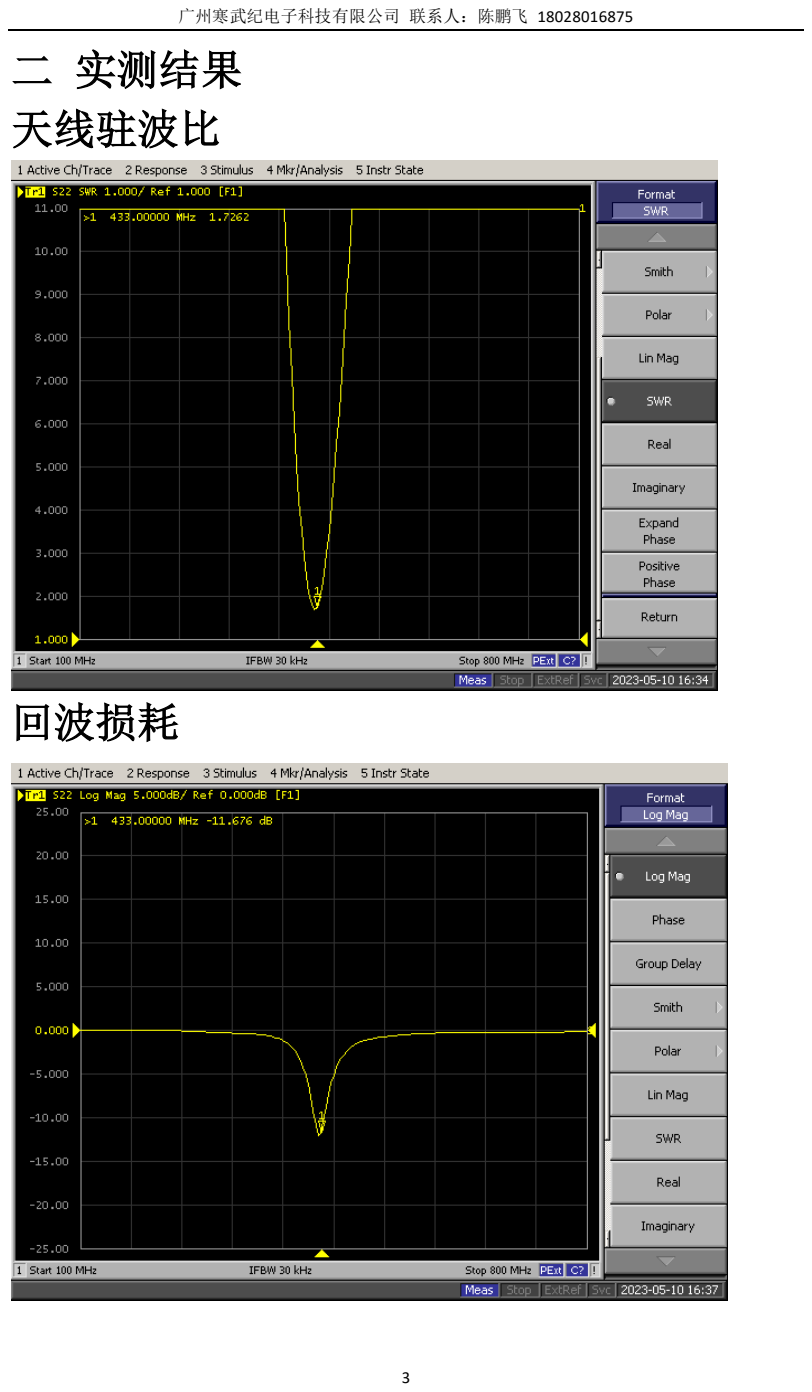
[picture p41: page 4]

# 回波损耗

# 三 结论

经过阻抗匹配器件的调试之后，这款产品的内置贴片天线各项指标满足内置 天线设计要求。

广州寒武纪电子科技有限公司
2023/05/10
