phoenix9668/RFID_CC1101_433MHz_V2/Doc/Purchase Contract/联想工控机采购.xls

mini
Description | Quantity | Purchasing Options | Cost | Total Cost | Necessary | Address | Purchasing Link
【政府补贴20%】联想小新Mini 高性能主机台式电脑主机 联想小新迷你mini主机 小机箱 带支架 | 1 | 颜色分类：i5-13420H/16G/1TB SSD/集显/Win11 | 3499 | 3499 | 必备 | 寄往呼市办公室 | https://detail.tmall.com/item.htm?abbucket=11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
 |  |  |  | 3499
