phoenix9668/RFID_CC1101_433MHz_V2/Doc/Purchase Contract/频谱分析仪.xls

频谱分析仪(1套)
Description | Quantity | U8编码 | Purchasing Options | Cost | Total Cost | Necessary | Address | Purchasing Link
近场探头 | 1 |  | 白色全套 | 60 | 60 | 必备 | 寄往呼市办公室 | https://item.taobao.com/item.htm?id=777091447381&skuId=5484428823683
TinySA ULTRA频谱分析仪 | 1 |  | TinySA ULTRA | 729.44 | 729.44 | 必备 | 寄往呼市办公室 | https://item.taobao.com/item.htm?id=731823250905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
 |  |  |  |  | 789.44
