phoenix9668/RFID_CC1101_433MHz_V2/Doc/Purchase Contract/18650耐低温锂电池(2022.11.1).xls

RFID
传感器及配件
Description | Quantity | Purchasing Options | Cost | Total Cost | Necessary | Address | Purchasing Link | 重要信息
长虹18650 -40℃低温锂电池3000mAh | 10 | 耐低温3000mAh | 43 | 430 | 必备 | 寄往北京办公室 | https://detail.tmall.com/item.htm?_u=t2dmg8j26111&id=596502254265&skuId=4731616144942
伍宾 -40度 耐低温 18650锂电池 2600mAh | 10 | 单节凸头带保护板 | 35 | 350 | 必备 | 寄往北京办公室 | https://detail.tmall.com/item.htm?_u=t2dmg8j26111&id=607538305129&skuId=4609063750334
 |  |  |  | 780
