phoenix9668/RFID_CC1101_433MHz_V2/Doc/Purchase Contract/血氧温度项圈控制板及传感器(2022.9.6).xls

RFID
传感器及配件
Description | Quantity | Purchasing Options | Cost | Total Cost | Necessary | Address | Purchasing Link | 重要信息
MAX30102心率血氧传感器模块 | 10 | MAX30102心率血氧传感器模块 | 8.1 | 81 | 必备 | 寄往呼市办公室 | https://detail.tmall.com/item.htm?id=601191237561&skuId=4203725308071
GY-MAX30100心率血氧传感器模块 | 10 | MAX30102 心率模块 | 15.8 | 158 | 必备 | 寄往呼市办公室 | https://detail.tmall.com/item.htm?id=655454054173&skuId=4899634854445
AHT21B数字温湿度传感器模块 | 10 | AHT21B标准款 | 6.8 | 68 | 必备 | 寄往呼市办公室 | https://item.taobao.com/item.htm?spm=a1z0d.6639537/tb.1997196601.28.24d07484X1wcND&id=644177817719
ESP32+SX1276蓝牙开发板 | 4 | wireless stick 开发板/433-470MHz/带天线 | 109.47 | 437.88 | 必备 | 寄往呼市办公室 | https://detail.tmall.com/item.htm?id=600533958592&skuId=4364571246996
Linux开发板 | 1 | 夸克开发板 现货可发 | 399 | 399 | 必备 | 寄往呼市办公室 | https://item.taobao.com/item.htm?spm=a1z0d.6639537/tb.1997196601.3.24d074848afL57&id=631246135630
热缩管 | 1 | 颜色选择：黑色 颜色分类：热缩管2MM 400米/卷 | 63 | 63 | 必备 | 寄往呼市办公室 | https://item.taobao.com/item.htm?id=585862792834&ali_trackid=1_c8f3b4656f83cec199ea7f7d9839a38d
 | 1 | 颜色选择：黑色 颜色分类：热缩管3MM 200米/卷 | 31 | 31 | 必备 | 寄往呼市办公室
 |  |  |  | 930.88
