phoenix9668/RFID_CC1101_433MHz_V2/Doc/Purchase Contract/联保-国科蓝海合同210913.xlsx

东莞市联保电子有限公司
购销合同
供方：东莞市联保电子有限公司 |  |  |  | 需方：北京国科蓝海科技有限公司
地址：广东省东莞市长安镇乌沙兴二路15号 |  |  |  | 地址：北京市海淀区上地佳园23号楼4层404
座机：0769-81666837 传真：0769-81666866 |  |  |  | 座机： 010-56299299
联系人：路先生 电话：13794951533 邮箱：lbdzllw@163.com |  |  |  | 联系人：于飞 电话：13683241996
（1）产品名称、型号、规格、数量、产品交期、金额； |  |  |  | 合同编号：YW2021091302 签约地点：东莞
序号 | 产品料号 | 品名 | 规格要求 | 数量 | 单位 | 单价 | 金额 | 备注
1 | SD7092A | 弹簧针 | 弹簧针： 外形尺寸：⌀1.8*10.7mm 颜色：金色 PIN材质：C3604 表面镀金：5U 弹力单pin：80±20g 电流：DC12V 3A 寿命：50000次 盐雾测试48H，人工汗测试48H | 200 | 个 | 0.78 | 156
2 | LBC0062D | 磁吸连接器 | 条形4PIN母端连接器： 外形尺寸：⌀26*8mm 颜色：黑色 PIN材质：C3604 表面镀金：5U 电流：DC12V 3A 寿命：50000次 磁铁等级：N35 吸附力200Kg 盐雾测试48H，人工汗测试48H | 100 | 个 | 4.8 | 480
3 | LBX0062A | 磁吸线 | 条形4PIN公端磁吸线材： 外形尺寸：⌀26*8mm 颜色：黑色，线长1000mm，材质TVC PIN材质：C3604 表面镀金：5U 弹力单pin：80±20g 电流：DC12V 3A 寿命：50000次 磁铁等级：N35 吸附力200Kg 盐雾测试48H，人工汗测试48H | 100 | 条 | 8.5 | 850
合计金额（大写）： |  |  |  |  |  | 合计金额： | 1486
END
（1）以上价格含税13%； |  |  |  | （2）付款方式：预付款50%安排生产，出货前付清尾款50%；
（3）产品交期：收到预付款后15天内交货； |  |  |  | （4）收货地址：需方提供地址（国内）
（5）以上产品均符合环保ROSH要求； |  |  |  | （6）包装方式：按供方出厂运输包装，并且符合、陆、船、空运输包装；
（7）收/发货：供方交货到需方所在地，运费由供方负责（国内）;需方（3个工作日内）进行实物样品验收后，货物风险转移到需方。
（8）验收标准：按照需方图纸要求，批量生产按供方提供经验需要签字确认的《承认书》及实物样品验收；如有异议，样品收到后五日内书面提出《质量异常反馈单》供方对不符合要求的产品重做或退货，所产生费用由供方负责。
收付款信息：
供方单位盖章：东莞市联保电子有限公司 |  |  |  | 需方单位盖章：北京国科蓝海科技有限公司
单位地址：东莞市长安镇乌沙兴二路15号 |  |  |  | 单位地址：广发银行股份有限公司北京望京支行
代表人签字： |  |  |  | 代表人签字：
税号：91441900MA529WJ56Y |  |  |  | 税号：911101085620967455
开户银行：中国工商银行东莞长安支行乌沙分理处 |  |  |  | 开户银行：广发银行股份有限公司北京望京支行
户名：东莞市联保电子有限公司 |  |  |  | 户名：北京国科蓝海科技有限公司
账号：2010 0272 0910 0083 903 |  |  |  | 账号：1372 6151 6010 001954
电话：0769-81666837 |  |  |  | 电话： 010-56299299
日期：2021年9月13日 |  |  |  | 日期：2021年9月13日
