phoenix9668/RFID_CC1101_433MHz_V2/Doc/Production Process/RFID项圈产品编号(2021.10.28).xlsx

产品编号 | 产品类别 | 产品日期 | 产品日期（简） | 产品批次 | 序列号 | 批次数量 | 批次成本 | 地址码 | 同步字 | 硬件UID | FRAM地址(10进制基数) | FRAM地址 | FRAM地址(补零) | FRAM写命令 | 发情数据扫描命令
302109010001 | 30 | 20210906 | 2109 | 01 | 0001 | 1200 | 310 | 0001 | E2DB | 30202109060100010001E2DB | 2 | 20 | 0020 | E55E00200130202109060100010001E2DB0001E2DB0D0A | 0A08A030202109060100010001E2DB0D0A
302109010002 | 30 | 20210906 | 2109 | 01 | 0002 | 1200 | 310 | 0002 | A864 | 30202109060100020002A864 | 3 | 30 | 0030 | E55E00300130202109060100020002A8640002A8640D0A | 0A08A030202109060100020002A8640D0A
302109010003 | 30 | 20210906 | 2109 | 01 | 0003 | 1200 |  | 0003 | 9CB8 | 302021090601000300039CB8 | 4 | 40 | 0040 | E55E004001302021090601000300039CB800039CB80D0A | 0A08A0302021090601000300039CB80D0A
302109010004 | 30 | 20210906 | 2109 | 01 | 0004 | 1200 |  | 0004 | CF9E | 30202109060100040004CF9E | 5 | 50 | 0050 | E55E00500130202109060100040004CF9E0004CF9E0D0A | 0A08A030202109060100040004CF9E0D0A
302109010005 | 30 | 20210906 | 2109 | 01 | 0005 | 1200 |  | 0005 | 7FBD | 302021090601000500057FBD | 6 | 60 | 0060 | E55E006001302021090601000500057FBD00057FBD0D0A | 0A08A0302021090601000500057FBD0D0A
302109010006 | 30 | 20210906 | 2109 | 01 | 0006 | 1200 |  | 0006 | BB96 | 30202109060100060006BB96 | 7 | 70 | 0070 | E55E00700130202109060100060006BB960006BB960D0A | 0A08A030202109060100060006BB960D0A
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
302109010586 | 30 | 20210906 | 2109 | 01 | 0586 | 1200 |  | 00BA | 8197 | 302021090601058600BA8197 | 587 | 24B0 | 24B0 | E55E24B001302021090601058600BA819700BA81970D0A | 0A08A0302021090601058600BA81970D0A
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
