phoenix9668/RFID_CC1101_433MHz_V2/Doc/3D body/VIC0250B.STEP

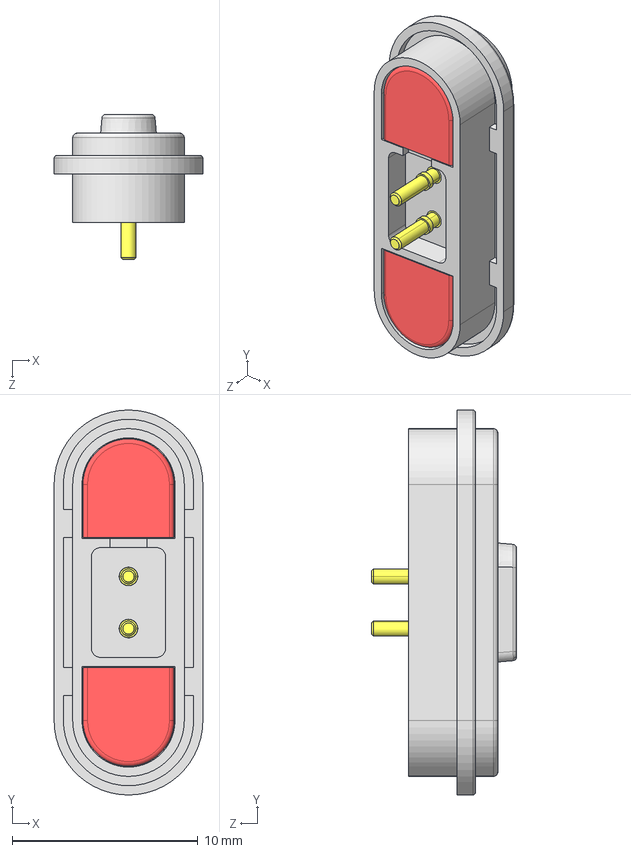
[picture p42: CAD file, 2026-06-24]
Doc/3D body/VIC0250B.STEP
8.00 x 20.7 x 7.80 mm
X0060B-00
M0062B-00 x 2
J0062C-00 x 2
