phoenix9668/RFID_CC1101_433MHz_V2/PCB/RFID_CC1101_433MHz_V3.8/PCB_RFID_CC1101_433MHz(2025.8.18)_2026-09-21.pdf

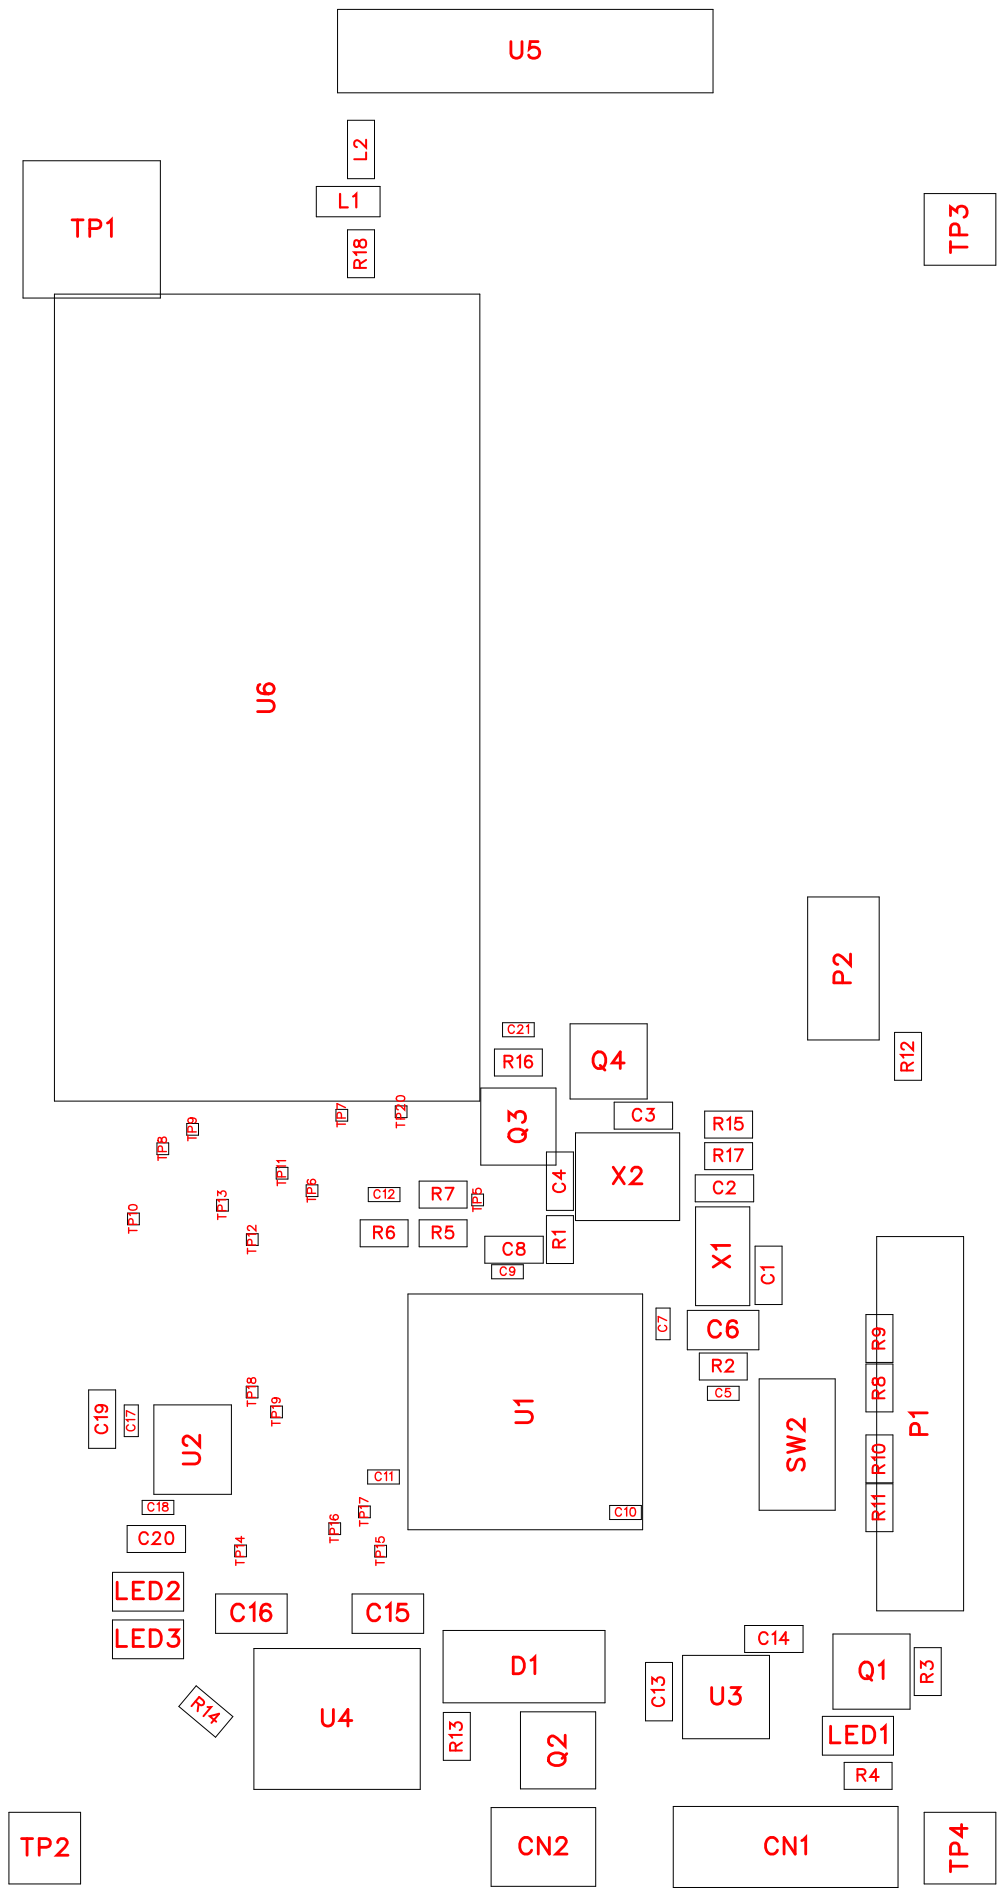
[picture p61: page 1]

BT1

No. | Quantity | Comment | Designator | Footprint | Value | Manufacturer Part | Manufacturer | Supplier Part | Supplier
1 | 1 | BH-16340 | BT1 | BATTERY-S MD_16340
2 | 2 | 10pF | C1,C2 | C0402 | 10pF | CC0402FRN PO9BN100 | YAGEO(国巨 ) | C513681 | LCSC
3 | 2 | 18pF | C3,C4 | C0402 | 18pF | CC0402FRN PO9BN180 | YAGEO(国巨 ) | C541431 | LCSC
4 | 9 | 100nF | C5,C7,C9,C10,C11,C12,C1 7,C18,C21 | C0402 | 100nF | GRM155R71 H104KE14D | muRata(村田 ) | C77020 | LCSC
5 | 3 | 10uF | C6,C15,C16 | C0603 | 10uF | GRM188R61 E106MA73D | muRata(村田 ) | C91606 | LCSC
6 | 5 | 1uF | C8,C13,C14,C19,C20 | C0402 | 1uF | GRM155R6Y A105KE11D | muRata(村田 ) | C361059 | LCSC
7 | 1 | HC-1.25-6A | CN1 | CONN-TH_6 P-P1.25_HC TL_HC-1.25-6A | | HC-1.25-6A | HCTL(华灿天 禄) | C2845524 | LCSC
8 | 1 | A1251WV-2P | CN2 | CONN-TH_2 P-P1.25_A12 51WV-2P | | A1251WV-2P | CJT(长江连 ) 接器 | C225090 | LCSC
9 | 1 | SS24A | D1 | SMA_L4.2-W 2.6-LS5.1-R D | | SS24A | FUXINSEMI( ) 富芯森美 | C842786 | LCSC
10 | 1 | 27nH | L1 | L0402-RD | 27nH | LQG15HS27 NJ02D | muRata(村田 ) | C12669 | LCSC
11 | 1 | 47nH | L2 | L0402 | 47nH | LQG15HS47 NJ02D | muRata(村田 ) | C97998 | LCSC
12 | 2 | XL-1608SYG C-06 | LED1,LED2 | LED0603-RD _GREEN | | XL-1608SYG C-06 | XINGLIGHT( 成兴光 ) | C965805 | LCSC
13 | 1 | XL-1608SUR C-06 | LED3 | LED0603-RD _RED | | XL-1608SUR C-06 | XINGLIGHT( 成兴光 ) | C965799 | LCSC
14 | 1 | A2541HWV-6P | P1 | HDR-TH_6P-P2.54-V-F | | A2541HWV-6P | CJT(长江连 ) 接器 | C2897443 | LCSC
15 | 1 | LBC0060B | P2 | LBC0060B
16 | 2 | S8050 | Q1,Q4 | SOT-23-3_L2 .9-W1.3-P1.9 0-LS2.4-BR | | S8050 | GOODWOR K(固得沃克 ) | C909746 | LCSC
17 | 2 | YJL2301C | Q2,Q3 | SOT-23-3_L2 .9-W1.3-P1.9 0-LS2.4-BR | | YJL2301C | YANGJIE( 扬 杰 ) | C699310 | LCSC
18 | 1 | 390 | R1 | R0402 | 390 | RC0402FR-0 7390RL | YAGEO(国巨 ) | C137997 | LCSC
19 | 4 | 10k | R2,R4,R12,R15 | R0402 | 10k | RC0402FR-0 710KL | YAGEO(国巨 ) | C60490 | LCSC
20 | 3 | 1k | R3,R14,R17 | R0402 | 1k | RC0402FR-0 71KL | YAGEO(国巨 ) | C106235 | LCSC
21 | 2 | 10M | R5,R6 | R0402 | 10M | RC0402FR-0 710ML | YAGEO(国巨 ) | C138067 | LCSC

22 | 2 | 0 | R7,R18 | R0402 | 0 | RC0402FR-0 70RL | YAGEO(国巨 ) | C106231 | LCSC
23 | 4 | 33 | R8,R9,R10,R11 | R0402 | 33 | RC0402FR-0 733RL | YAGEO(国巨 ) | C138002 | LCSC
24 | 1 | 1.2k | R13 | R0402 | 1.2k | RC0402FR-0 71K2L | YAGEO(国巨 ) | C138040 | LCSC
25 | 1 | 100k | R16 | R0402 | 100k | RC0402FR-0 7100KL | YAGEO(国巨 ) | C60491 | LCSC
26 | 1 | TS-1088R-02 526 | SW2 | SW-SMD_L3 .9-W3.0-P4.4 5 | | TS-1088R-02 526 | XUNPU(讯普 ) | C455281 | LCSC
27 | 1 | M2铜柱 | TP1 | th_bd4.0-d2. 0 | | M2铜柱 | | C990000468 4 | LCSC
28 | 3 | M2铜柱 | TP2,TP3,TP4 | TH_BD4.0-D 2.0_1 | | M2铜柱 | | C990000468 4 | LCSC
29 | 16 | Test-Point | TP5,TP6,TP7,TP8,TP9,TP1 0,TP11,TP12,TP13,TP14,T P15,TP16,TP17,TP18,TP19 ,TP20 | Test-Point-0. 5mm
30 | 1 | STM32L051 C8T6 | U1 | LQFP-48_L7. 0-W7.0-P0.5 0-LS9.0-BL | | STM32L051 C8T6 | ST(意法半导 体) | C110878 | LCSC
31 | 1 | ADXL362BC CZ-RL | U2 | LGA-16_L3.0 -W3.0-P0.50-BL | | ADXL362BC CZ-RL | ADI(亚德诺 ) | C59641 | LCSC
32 | 1 | LP5907MFX-3.0/NOPB | U3 | SOT-23-5_L3 .0-W1.7-P0.9 5-LS2.8-BL | | LP5907MFX-3.0/NOPB | TI(德州仪器 ) | C475492 | LCSC
33 | 1 | TP4056-42-E SOP8 | U4 | ESOP-8_L4. 9-W3.9-P1.2 7-LS6.0-BL-E P | | TP4056-42-E SOP8 | TOPPOWER (南京拓微) | C16581 | LCSC
34 | 1 | CA-S01 | U5 | ANT-SMD_L 15.0-W3.0 | | CA-S01 | | C2858568 | LCSC
35 | 1 | E07-433M20 S | U6 | PE07-433M2 0S | Isupply(uA) = 2; Vin(V) = 2.1-3.6; Iout( max)(mA) = 100;
36 | 1 | 32.768kHz | X1 | CRYSTAL-S MD_L3.2-W1 .5-1 | 32.768kHz | XKXGI-SUA-32.768K | YXC(扬兴晶 振) | C5213671 | LCSC
37 | 1 | 12MHz | X2 | CRYSTAL-S MD_4P-L3.2-W2.5-BL | 12MHz | X322512MS B4SI | YXC(扬兴晶 振) | C9002 | LCSC

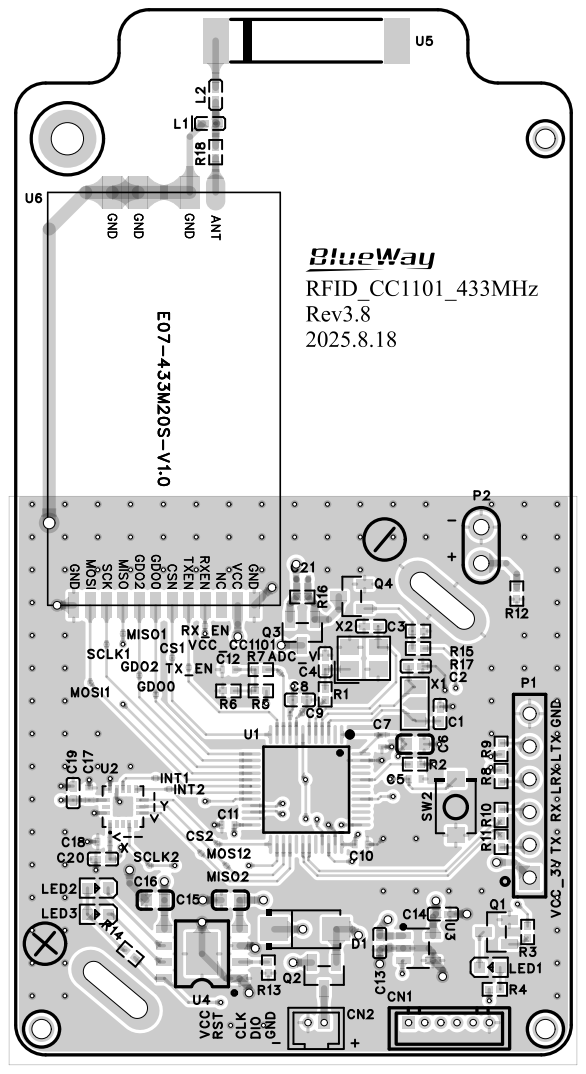
[picture p62: page 5]

LTX LRX GND TX RX

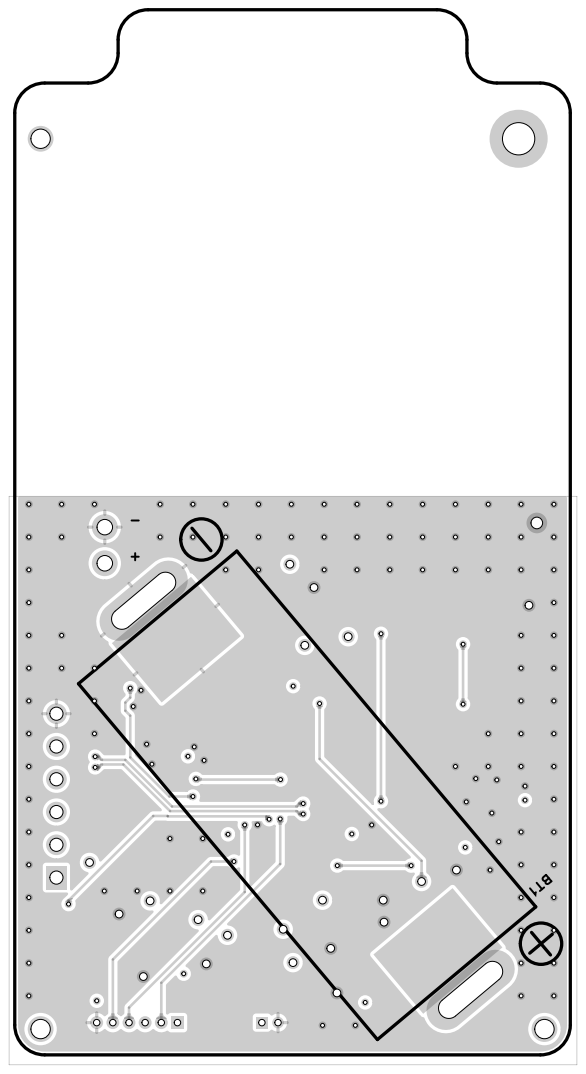
[picture p63: page 6]

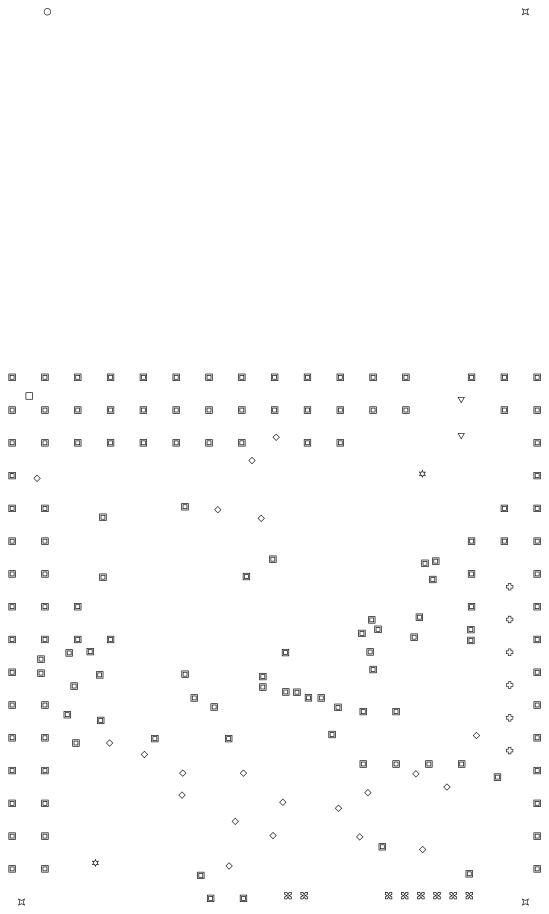
[picture p64: page 7]
