phoenix9668/RFID_CC1101_433MHz_V2/PCB/RFID_CC1101_433MHz_V3.8/SCH_RFID_CC1101_433MHz(2025.8.18)_2026-09-21.pdf

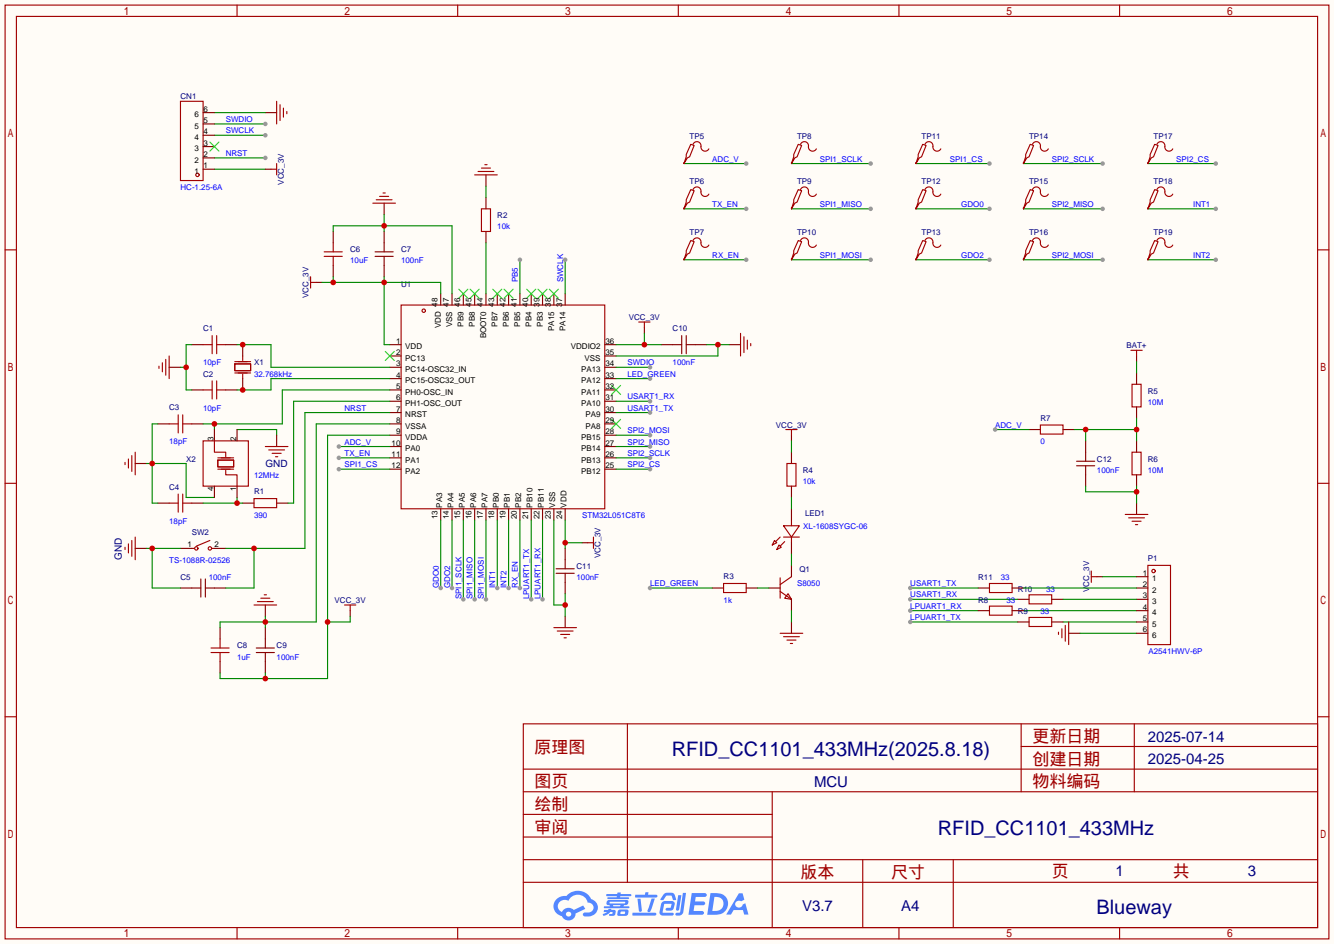
[picture p66: page 1]

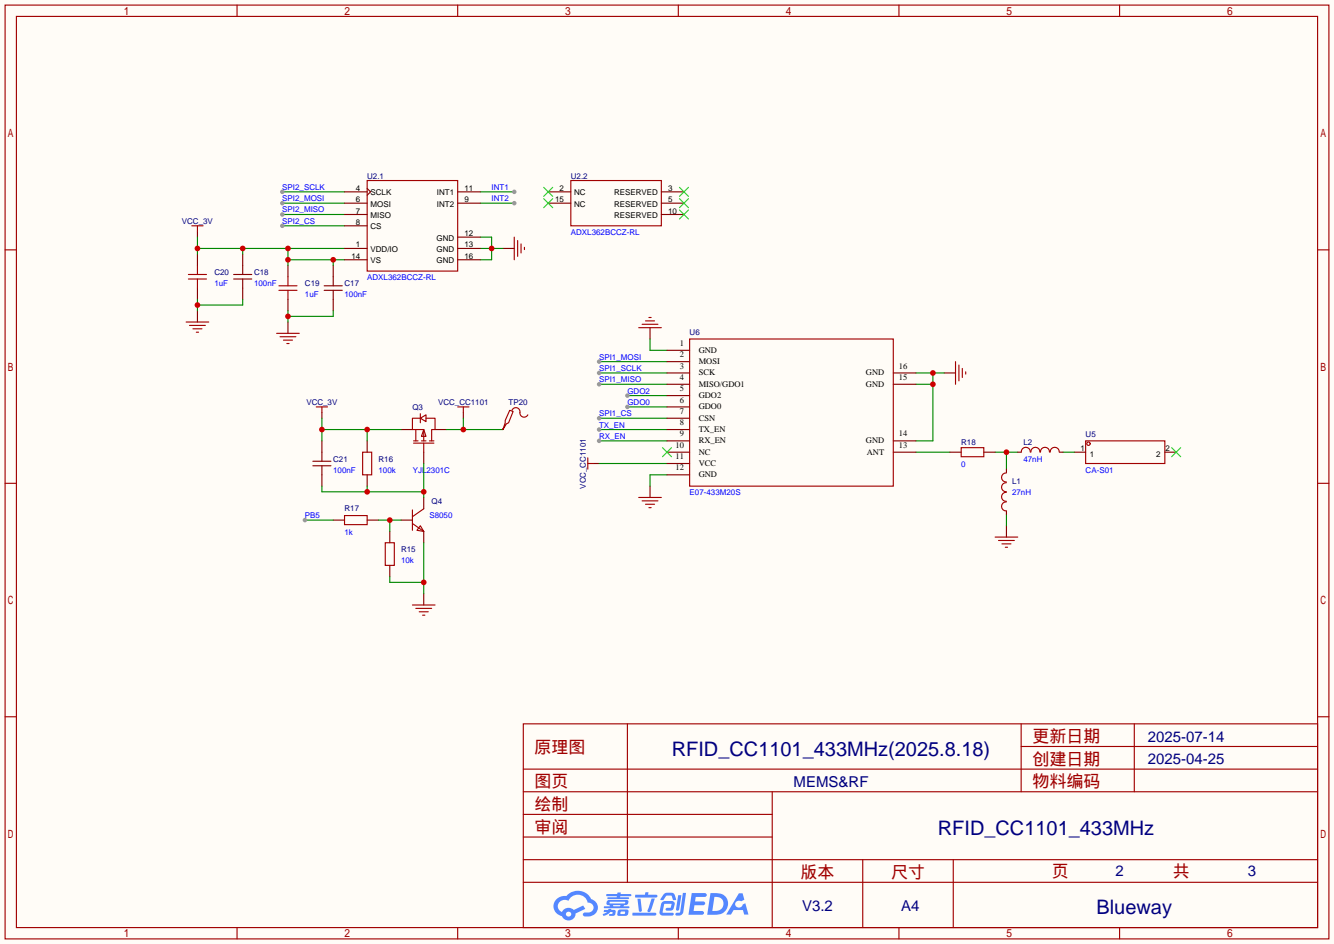
[picture p67: page 2]

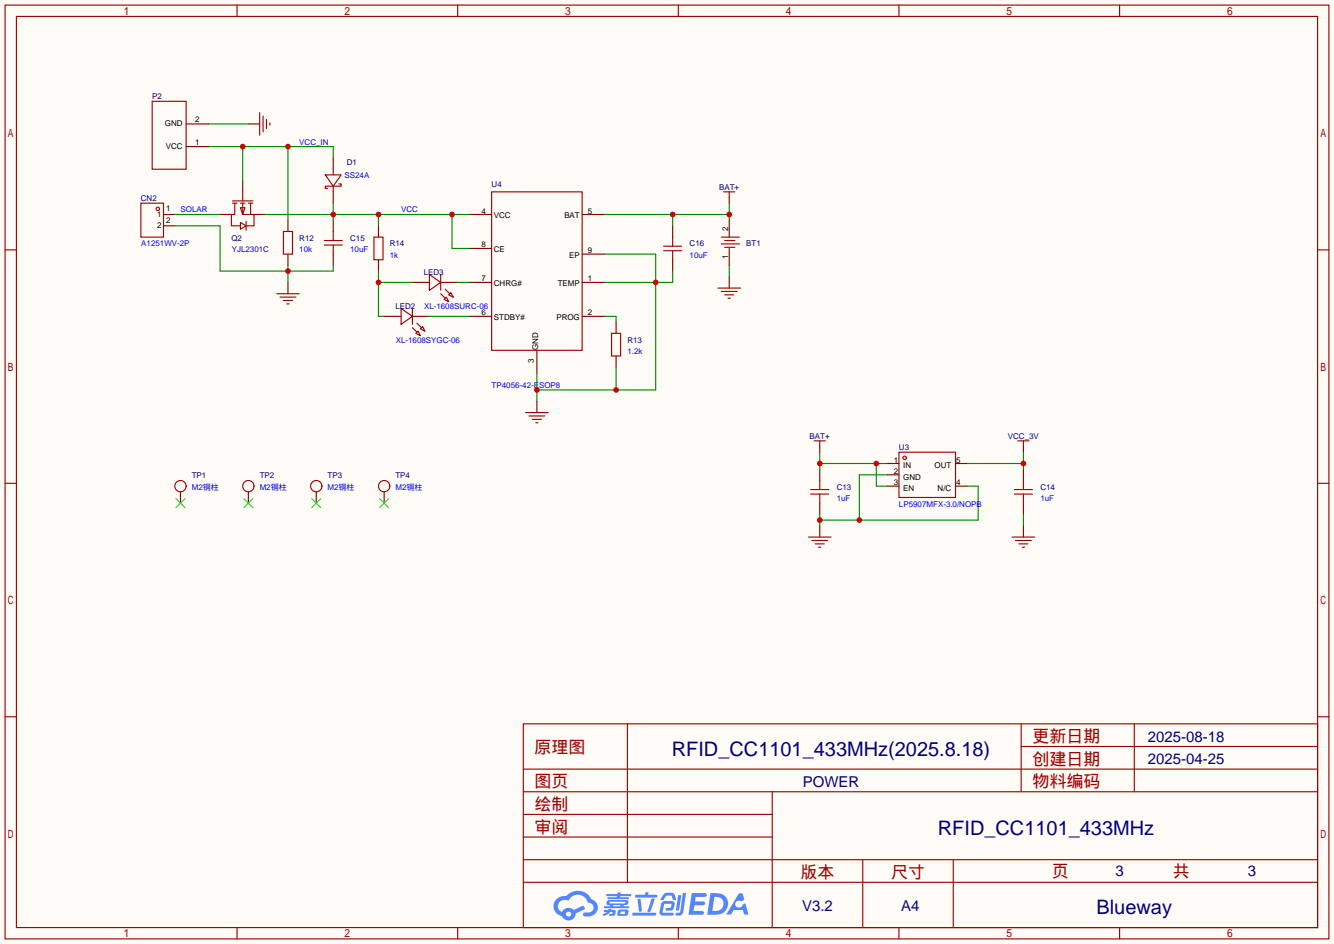
[picture p68: page 3]
