phoenix9668/RFID_CC1101_433MHz_V2/Doc/3D body/LBX0060A( 2Pin Magnet cable )+母端连接器.pdf

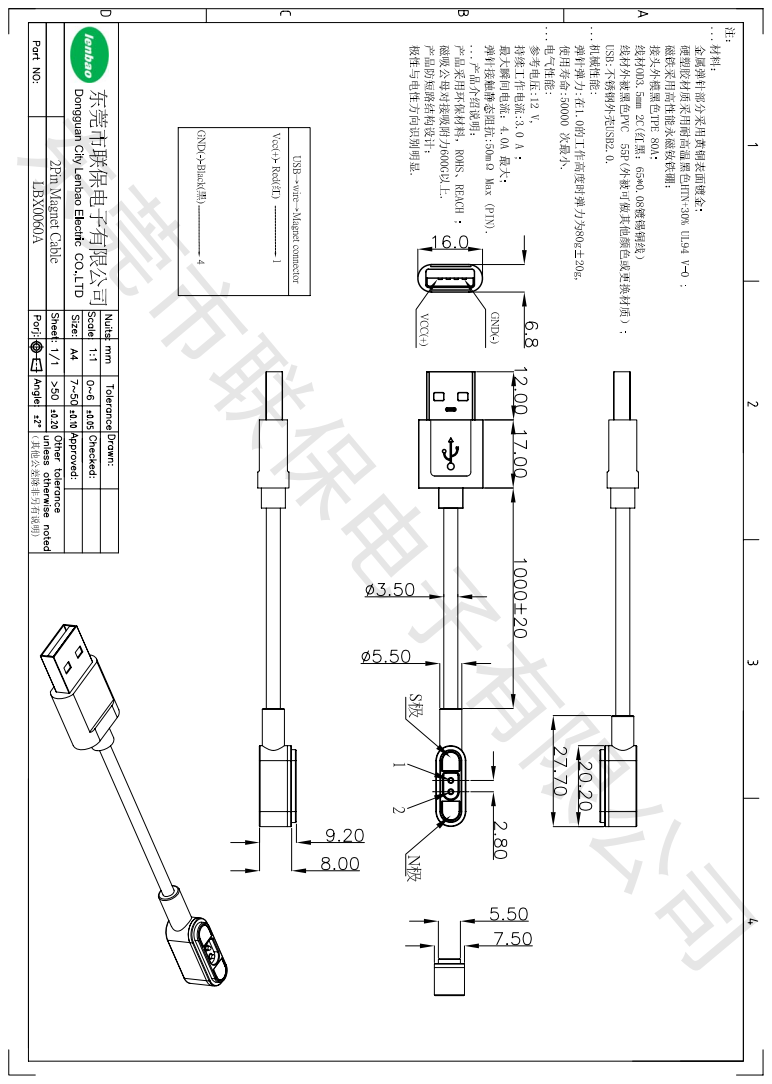
[picture p69: page 1]
东莞市联保电子有限公司

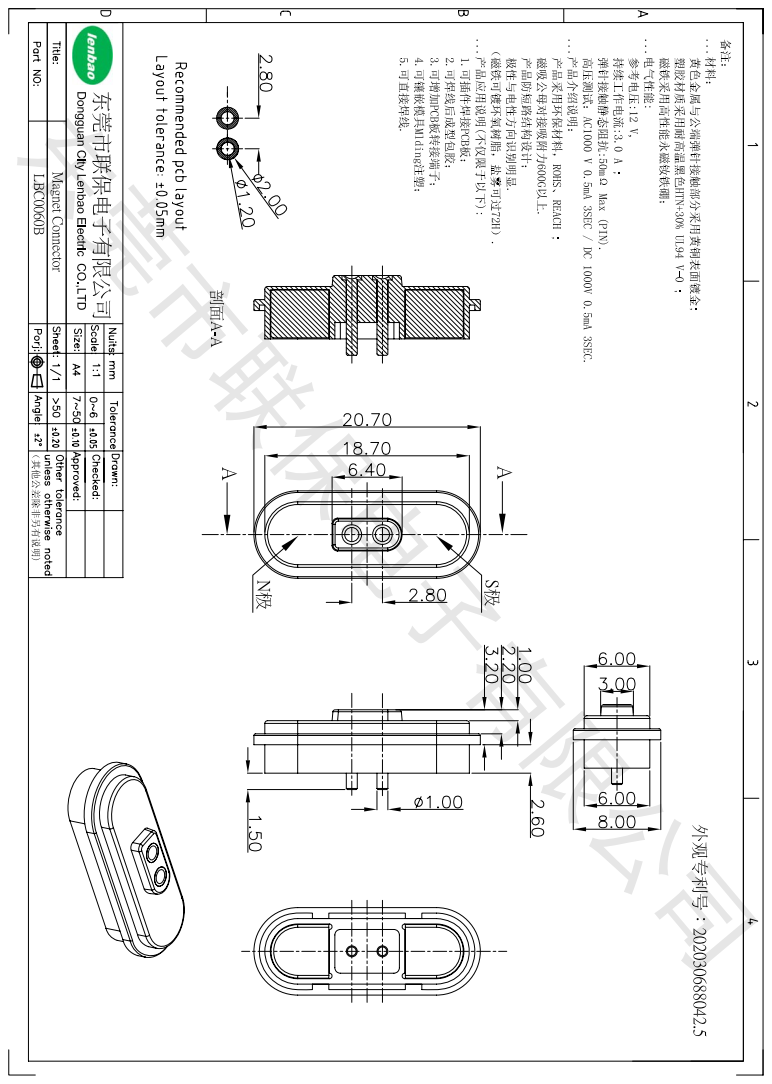
[picture p70: page 2]
东莞市联保电子有限公司
