phoenix9668/RFID_CC1101_433MHz_V2/(list of files, drawings)

Other design files:
PCB/RFID_CC1101_433MHz_V3.0/Power.SchDoc
PCB/RFID_CC1101_433MHz_V3.0/RFID_CC1101_433MHz.PrjPcb
PCB/RFID_CC1101_433MHz_V3.0/RFID_CC1101_433MHz.SchDoc
