phoenix9668/RFID_CC1101_433MHz_V2/RFID_CC1101_433MHz_V2.ioc

Mcu.UserName=STM32L051C8Tx
PA0.GPIO_Label=ADC_V
PA0.Signal=ADC_IN0
PA1.GPIO_Label=TX_EN
PA1.Signal=GPIO_Output
PA10.Signal=USART1_RX
PA12.GPIO_Label=LED_GREEN
PA12.Signal=GPIO_Output
PA13.Signal=SYS_SWDIO
PA14.Signal=SYS_SWCLK
PA15.GPIO_Label=PA15
PA15.Signal=GPIO_Output
PA2.GPIO_Label=SPI1_CS
PA2.Signal=GPIO_Output
PA3.GPIO_Label=GDO0
PA3.Signal=GPXTI3
PA4.GPIO_Label=GDO2
PA4.Signal=GPXTI4
PA5.Signal=SPI1_SCK
PA6.Signal=SPI1_MISO
PA7.Signal=SPI1_MOSI
PA8.Signal=RCC_MCO
PA9.Signal=USART1_TX
PB1.GPIO_Label=INT2
PB1.Signal=GPXTI1
PB12.GPIO_Label=SPI2_CS
PB12.Signal=GPIO_Output
PB13.Signal=SPI2_SCK
PB14.Signal=SPI2_MISO
PB15.Signal=SPI2_MOSI
PB2.GPIO_Label=RX_EN
PB2.Signal=GPIO_Output
PB5.GPIO_Label=PB5
PB5.Signal=GPIO_Output
PC14-OSC32_IN.Signal=RCC_OSC32_IN
PC15-OSC32_OUT.Signal=RCC_OSC32_OUT
PH0-OSC_IN.Signal=RCC_OSC_IN
PH1-OSC_OUT.Signal=RCC_OSC_OUT
