phoenix9668/RFID_CC1101_433MHz_V2/Core/Inc/main.h

#define EEPROM_START_ADDR   0x08080000   /* Start @ of user eeprom area */
#define PI 3.1415926
#define _DEBUG              0        //  set device info
#define _RFID_PRINT_DEBUG   0	        //  use printf debug
#define _Original_Data_Algorithm   1 //  use original data algorithm
#define ADC_V_Pin LL_GPIO_PIN_0
#define ADC_V_GPIO_Port GPIOA
#define TX_EN_Pin LL_GPIO_PIN_1
#define TX_EN_GPIO_Port GPIOA
#define SPI1_CS_Pin LL_GPIO_PIN_2
#define SPI1_CS_GPIO_Port GPIOA
#define GDO0_Pin LL_GPIO_PIN_3
#define GDO0_GPIO_Port GPIOA
#define GDO0_EXTI_IRQn EXTI2_3_IRQn
#define GDO2_Pin LL_GPIO_PIN_4
#define GDO2_GPIO_Port GPIOA
#define GDO2_EXTI_IRQn EXTI4_15_IRQn
#define INT2_Pin LL_GPIO_PIN_1
#define INT2_GPIO_Port GPIOB
#define INT2_EXTI_IRQn EXTI0_1_IRQn
#define RX_EN_Pin LL_GPIO_PIN_2
#define RX_EN_GPIO_Port GPIOB
#define SPI2_CS_Pin LL_GPIO_PIN_12
#define SPI2_CS_GPIO_Port GPIOB
#define LED_GREEN_Pin LL_GPIO_PIN_12
#define LED_GREEN_GPIO_Port GPIOA
#define PA15_Pin LL_GPIO_PIN_15
#define PA15_GPIO_Port GPIOA
#define PB5_Pin LL_GPIO_PIN_5
#define PB5_GPIO_Port GPIOB
