phoenix9668/RFID_CC1101_433MHz_V2/Core/Src/spi.c

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
/* Includes ------------------------------------------------------------------*/
#include "spi.h"

/* SPI1 init function */
void MX_SPI1_Init(void)
{

  LL_SPI_InitTypeDef SPI_InitStruct = {0};

  LL_GPIO_InitTypeDef GPIO_InitStruct = {0};

  /* Peripheral clock enable */
  LL_APB2_GRP1_EnableClock(LL_APB2_GRP1_PERIPH_SPI1);

  LL_IOP_GRP1_EnableClock(LL_IOP_GRP1_PERIPH_GPIOA);
  /**SPI1 GPIO Configuration
  PA5   ------> SPI1_SCK
  PA6   ------> SPI1_MISO
  PA7   ------> SPI1_MOSI
  */
  GPIO_InitStruct.Pin = LL_GPIO_PIN_5;
  GPIO_InitStruct.Mode = LL_GPIO_MODE_ALTERNATE;
  GPIO_InitStruct.Speed = LL_GPIO_SPEED_FREQ_VERY_HIGH;
  GPIO_InitStruct.OutputType = LL_GPIO_OUTPUT_PUSHPULL;
  GPIO_InitStruct.Pull = LL_GPIO_PULL_NO;
  GPIO_InitStruct.Alternate = LL_GPIO_AF_0;
  LL_GPIO_Init(GPIOA, &GPIO_InitStruct);

  GPIO_InitStruct.Pin = LL_GPIO_PIN_6;
  GPIO_InitStruct.Mode = LL_GPIO_MODE_ALTERNATE;
  GPIO_InitStruct.Speed = LL_GPIO_SPEED_FREQ_VERY_HIGH;
  GPIO_InitStruct.OutputType = LL_GPIO_OUTPUT_PUSHPULL;
  GPIO_InitStruct.Pull = LL_GPIO_PULL_NO;
  GPIO_InitStruct.Alternate = LL_GPIO_AF_0;
  LL_GPIO_Init(GPIOA, &GPIO_InitStruct);

  GPIO_InitStruct.Pin = LL_GPIO_PIN_7;
  GPIO_InitStruct.Mode = LL_GPIO_MODE_ALTERNATE;
  GPIO_InitStruct.Speed = LL_GPIO_SPEED_FREQ_VERY_HIGH;
  GPIO_InitStruct.OutputType = LL_GPIO_OUTPUT_PUSHPULL;
  GPIO_InitStruct.Pull = LL_GPIO_PULL_NO;
  GPIO_InitStruct.Alternate = LL_GPIO_AF_0;
  LL_GPIO_Init(GPIOA, &GPIO_InitStruct);

  /* USER CODE BEGIN SPI1_Init 1 */
    GPIO_InitStruct.Pin = SPI1_CS_Pin;
    GPIO_InitStruct.Mode = LL_GPIO_MODE_OUTPUT;
    GPIO_InitStruct.Speed = LL_GPIO_SPEED_FREQ_LOW;
    GPIO_InitStruct.OutputType = LL_GPIO_OUTPUT_PUSHPULL;
    GPIO_InitStruct.Pull = LL_GPIO_PULL_UP;
    LL_GPIO_Init(SPI1_CS_GPIO_Port, &GPIO_InitStruct);
  /* USER CODE END SPI1_Init 1 */
  SPI_InitStruct.TransferDirection = LL_SPI_FULL_DUPLEX;
  SPI_InitStruct.Mode = LL_SPI_MODE_MASTER;
  SPI_InitStruct.DataWidth = LL_SPI_DATAWIDTH_8BIT;
  SPI_InitStruct.ClockPolarity = LL_SPI_POLARITY_LOW;
  SPI_InitStruct.ClockPhase = LL_SPI_PHASE_1EDGE;
  SPI_InitStruct.NSS = LL_SPI_NSS_SOFT;
  SPI_InitStruct.BaudRate = LL_SPI_BAUDRATEPRESCALER_DIV2;
  SPI_InitStruct.BitOrder = LL_SPI_MSB_FIRST;
  SPI_InitStruct.CRCCalculation = LL_SPI_CRCCALCULATION_DISABLE;
  SPI_InitStruct.CRCPoly = 7;
  LL_SPI_Init(SPI1, &SPI_InitStruct);
  LL_SPI_SetStandard(SPI1, LL_SPI_PROTOCOL_MOTOROLA);
  /* USER CODE BEGIN SPI1_Init 2 */
    Activate_SPI(SPI1);
  /* USER CODE END SPI1_Init 2 */

}
/* SPI2 init function */
void MX_SPI2_Init(void)
{

  LL_SPI_InitTypeDef SPI_InitStruct = {0};

  LL_GPIO_InitTypeDef GPIO_InitStruct = {0};

  /* Peripheral clock enable */
  LL_APB1_GRP1_EnableClock(LL_APB1_GRP1_PERIPH_SPI2);

  LL_IOP_GRP1_EnableClock(LL_IOP_GRP1_PERIPH_GPIOB);
  /**SPI2 GPIO Configuration
  PB13   ------> SPI2_SCK
  PB14   ------> SPI2_MISO
  PB15   ------> SPI2_MOSI
  */
  GPIO_InitStruct.Pin = LL_GPIO_PIN_13;
  GPIO_InitStruct.Mode = LL_GPIO_MODE_ALTERNATE;
  GPIO_InitStruct.Speed = LL_GPIO_SPEED_FREQ_VERY_HIGH;
  GPIO_InitStruct.OutputType = LL_GPIO_OUTPUT_PUSHPULL;
  GPIO_InitStruct.Pull = LL_GPIO_PULL_NO;
  GPIO_InitStruct.Alternate = LL_GPIO_AF_0;
  LL_GPIO_Init(GPIOB, &GPIO_InitStruct);

  GPIO_InitStruct.Pin = LL_GPIO_PIN_14;
  GPIO_InitStruct.Mode = LL_GPIO_MODE_ALTERNATE;
  GPIO_InitStruct.Speed = LL_GPIO_SPEED_FREQ_VERY_HIGH;
  GPIO_InitStruct.OutputType = LL_GPIO_OUTPUT_PUSHPULL;
  GPIO_InitStruct.Pull = LL_GPIO_PULL_NO;
  GPIO_InitStruct.Alternate = LL_GPIO_AF_0;
  LL_GPIO_Init(GPIOB, &GPIO_InitStruct);

  GPIO_InitStruct.Pin = LL_GPIO_PIN_15;
  GPIO_InitStruct.Mode = LL_GPIO_MODE_ALTERNATE;
  GPIO_InitStruct.Speed = LL_GPIO_SPEED_FREQ_VERY_HIGH;
  GPIO_InitStruct.OutputType = LL_GPIO_OUTPUT_PUSHPULL;
  GPIO_InitStruct.Pull = LL_GPIO_PULL_NO;
  GPIO_InitStruct.Alternate = LL_GPIO_AF_0;
  LL_GPIO_Init(GPIOB, &GPIO_InitStruct);

  /* USER CODE BEGIN SPI2_Init 1 */
    GPIO_InitStruct.Pin = SPI2_CS_Pin;
    GPIO_InitStruct.Mode = LL_GPIO_MODE_OUTPUT;
    GPIO_InitStruct.Speed = LL_GPIO_SPEED_FREQ_LOW;
    GPIO_InitStruct.OutputType = LL_GPIO_OUTPUT_PUSHPULL;
    GPIO_InitStruct.Pull = LL_GPIO_PULL_UP;
    LL_GPIO_Init(SPI2_CS_GPIO_Port, &GPIO_InitStruct);
  /* USER CODE END SPI2_Init 1 */
  SPI_InitStruct.TransferDirection = LL_SPI_FULL_DUPLEX;
  SPI_InitStruct.Mode = LL_SPI_MODE_MASTER;
  SPI_InitStruct.DataWidth = LL_SPI_DATAWIDTH_8BIT;
  SPI_InitStruct.ClockPolarity = LL_SPI_POLARITY_LOW;
  SPI_InitStruct.ClockPhase = LL_SPI_PHASE_1EDGE;
  SPI_InitStruct.NSS = LL_SPI_NSS_SOFT;
  SPI_InitStruct.BaudRate = LL_SPI_BAUDRATEPRESCALER_DIV2;
  SPI_InitStruct.BitOrder = LL_SPI_MSB_FIRST;
  SPI_InitStruct.CRCCalculation = LL_SPI_CRCCALCULATION_DISABLE;
  SPI_InitStruct.CRCPoly = 7;
  LL_SPI_Init(SPI2, &SPI_InitStruct);
  LL_SPI_SetStandard(SPI2, LL_SPI_PROTOCOL_MOTOROLA);
  /* USER CODE BEGIN SPI2_Init 2 */
    Activate_SPI(SPI2);
  /* USER CODE END SPI2_Init 2 */

}

/* USER CODE BEGIN 1 */

void MX_SPI1_DeInit(void)
{
    LL_GPIO_InitTypeDef GPIO_InitStruct = {0};

    /* Peripheral clock enable */
    LL_APB2_GRP1_DisableClock(LL_APB2_GRP1_PERIPH_SPI1);

    LL_IOP_GRP1_EnableClock(LL_IOP_GRP1_PERIPH_GPIOA);
    /**SPI1 GPIO Configuration
    PA2   ------> SPI1_CS
    PA5   ------> SPI1_SCK
    PA6   ------> SPI1_MISO
    PA7   ------> SPI1_MOSI
    */
    GPIO_InitStruct.Pin = LL_GPIO_PIN_2;
    GPIO_InitStruct.Mode = LL_GPIO_MODE_ANALOG;
    GPIO_InitStruct.Pull = LL_GPIO_PULL_NO;
    LL_GPIO_Init(GPIOA, &GPIO_InitStruct);

    GPIO_InitStruct.Pin = LL_GPIO_PIN_5;
    GPIO_InitStruct.Mode = LL_GPIO_MODE_ANALOG;
    GPIO_InitStruct.Pull = LL_GPIO_PULL_NO;
    LL_GPIO_Init(GPIOA, &GPIO_InitStruct);

    GPIO_InitStruct.Pin = LL_GPIO_PIN_6;
    GPIO_InitStruct.Mode = LL_GPIO_MODE_ANALOG;
    GPIO_InitStruct.Pull = LL_GPIO_PULL_NO;
    LL_GPIO_Init(GPIOA, &GPIO_InitStruct);

    GPIO_InitStruct.Pin = LL_GPIO_PIN_7;
    GPIO_InitStruct.Mode = LL_GPIO_MODE_ANALOG;
    GPIO_InitStruct.Pull = LL_GPIO_PULL_NO;
    LL_GPIO_Init(GPIOA, &GPIO_InitStruct);

    LL_SPI_Disable(SPI1);
    LL_SPI_DeInit(SPI1);
}

void MX_SPI2_DeInit(void)
{
    LL_GPIO_InitTypeDef GPIO_InitStruct = {0};

    /* Peripheral clock enable */
    LL_APB1_GRP1_DisableClock(LL_APB1_GRP1_PERIPH_SPI2);

    LL_IOP_GRP1_EnableClock(LL_IOP_GRP1_PERIPH_GPIOB);
    /**SPI2 GPIO Configuration
    PB12   ------> SPI2_CS
    PB13   ------> SPI2_SCK
    PB14   ------> SPI2_MISO
    PB15   ------> SPI2_MOSI
    */
    GPIO_InitStruct.Pin = LL_GPIO_PIN_12;
    GPIO_InitStruct.Mode = LL_GPIO_MODE_ANALOG;
    GPIO_InitStruct.Pull = LL_GPIO_PULL_NO;
    LL_GPIO_Init(GPIOB, &GPIO_InitStruct);

    GPIO_InitStruct.Pin = LL_GPIO_PIN_13;
    GPIO_InitStruct.Mode = LL_GPIO_MODE_ANALOG;
    GPIO_InitStruct.Pull = LL_GPIO_PULL_NO;
    LL_GPIO_Init(GPIOB, &GPIO_InitStruct);

    GPIO_InitStruct.Pin = LL_GPIO_PIN_14;
    GPIO_InitStruct.Mode = LL_GPIO_MODE_ANALOG;
    GPIO_InitStruct.Pull = LL_GPIO_PULL_NO;
    LL_GPIO_Init(GPIOB, &GPIO_InitStruct);

    GPIO_InitStruct.Pin = LL_GPIO_PIN_15;
    GPIO_InitStruct.Mode = LL_GPIO_MODE_ANALOG;
    GPIO_InitStruct.Pull = LL_GPIO_PULL_NO;
    LL_GPIO_Init(GPIOB, &GPIO_InitStruct);

    LL_SPI_Disable(SPI2);
    LL_SPI_DeInit(SPI2);
}

/**
  * @brief  This function Activate SPI
  * @param  None
  * @retval None
  */
void Activate_SPI(SPI_TypeDef *SPIx)
{
    /* Enable SPI1 */
    LL_SPI_Enable(SPIx);
}

uint8_t SPI_ExchangeByte(SPI_TypeDef *SPIx, uint8_t input)
{
    LL_SPI_TransmitData8(SPIx, input);

    while (!LL_SPI_IsActiveFlag_TXE(SPIx)) {};

    while (!LL_SPI_IsActiveFlag_RXNE(SPIx)) {};

    return (LL_SPI_ReceiveData8(SPIx));
}

// Function for sending and receiving data through SPI
void SpiFunction(SPI_TypeDef *SPIx, uint8_t *OutputBuff, uint8_t *InputBuff, uint16_t OutNoOfBytes, uint16_t InNoOfBytes)
{
    uint16_t i;

    for(i = 0; i < OutNoOfBytes; i++)
    {
        SPI_ExchangeByte(SPIx, OutputBuff[i]);					// Send data
    }

    for(i = 0; i < InNoOfBytes; i++)
    {
        InputBuff[i] = SPI_ExchangeByte(SPIx, 0xFF);		// Receive data
    }
}
/* USER CODE END 1 */
