phoenix9668/RFID_CC1101_433MHz_V2/Core/Src/rtc.c

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
/* Includes ------------------------------------------------------------------*/
#include "rtc.h"

/* USER CODE BEGIN 0 */
#include "adxl362.h"
rtc_t rtc;
/* USER CODE END 0 */

RTC_HandleTypeDef hrtc;

/* RTC init function */
void MX_RTC_Init(void)
{

  /** Initialize RTC Only
  */
  hrtc.Instance = RTC;
  hrtc.Init.HourFormat = RTC_HOURFORMAT_24;
  hrtc.Init.AsynchPrediv = 127;
  hrtc.Init.SynchPrediv = 255;
  hrtc.Init.OutPut = RTC_OUTPUT_DISABLE;
  hrtc.Init.OutPutRemap = RTC_OUTPUT_REMAP_NONE;
  hrtc.Init.OutPutPolarity = RTC_OUTPUT_POLARITY_HIGH;
  hrtc.Init.OutPutType = RTC_OUTPUT_TYPE_OPENDRAIN;
  if (HAL_RTC_Init(&hrtc) != HAL_OK)
  {
    Error_Handler();
  }

  /** Enable the WakeUp
  */
  if (HAL_RTCEx_SetWakeUpTimer_IT(&hrtc, 0x5000, RTC_WAKEUPCLOCK_RTCCLK_DIV16) != HAL_OK)
  {
    Error_Handler();
  }
}

void HAL_RTC_MspInit(RTC_HandleTypeDef* rtcHandle)
{

  if(rtcHandle->Instance==RTC)
  {
    /* RTC clock enable */
    __HAL_RCC_RTC_ENABLE();

    /* RTC interrupt Init */
    HAL_NVIC_SetPriority(RTC_IRQn, 2, 0);
    HAL_NVIC_EnableIRQ(RTC_IRQn);
  }
}

void HAL_RTC_MspDeInit(RTC_HandleTypeDef* rtcHandle)
{

  if(rtcHandle->Instance==RTC)
  {
    /* Peripheral clock disable */
    __HAL_RCC_RTC_DISABLE();

    /* RTC interrupt Deinit */
    HAL_NVIC_DisableIRQ(RTC_IRQn);
  }
}

/* USER CODE BEGIN 1 */

/**
  * @brief  RTC Wake Up callback
  * @param  None
  * @retval None
  */
void HAL_RTCEx_WakeUpTimerEventCallback(RTC_HandleTypeDef *hrtc)
{
    /* Clear Wake Up Flag */
    __HAL_PWR_CLEAR_FLAG(PWR_FLAG_WU);

    rtc.tenSecTick++;

    if((rtc.tenSecTick % 12) == 0) //120s
    {
        rtc.tenSecIndex = SET;
    }

    // if(rtc.tenSecTick >= 30)//300s=5min
    if(rtc.tenSecTick >= 120)//1200s=20min
    // if(rtc.tenSecTick >= 360)//3600s=1hour
    {
        rtc.twentyMinIndex = SET;
        rtc.tenSecTick = 0x00;
    }
}

/* USER CODE END 1 */
