phoenix9668/RFID_CC1101_433MHz_V2/Core/Src/adc.c

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
/* Includes ------------------------------------------------------------------*/
#include "adc.h"

/* USER CODE BEGIN 0 */
adc_t adc;
/* USER CODE END 0 */

ADC_HandleTypeDef hadc;

/* ADC init function */
void MX_ADC_Init(void)
{

  ADC_ChannelConfTypeDef sConfig = {0};

  /** Configure the global features of the ADC (Clock, Resolution, Data Alignment and number of conversion)
  */
  hadc.Instance = ADC1;
  hadc.Init.OversamplingMode = DISABLE;
  hadc.Init.ClockPrescaler = ADC_CLOCK_SYNC_PCLK_DIV2;
  hadc.Init.Resolution = ADC_RESOLUTION_12B;
  hadc.Init.SamplingTime = ADC_SAMPLETIME_19CYCLES_5;
  hadc.Init.ScanConvMode = ADC_SCAN_DIRECTION_FORWARD;
  hadc.Init.DataAlign = ADC_DATAALIGN_RIGHT;
  hadc.Init.ContinuousConvMode = DISABLE;
  hadc.Init.DiscontinuousConvMode = DISABLE;
  hadc.Init.ExternalTrigConvEdge = ADC_EXTERNALTRIGCONVEDGE_NONE;
  hadc.Init.ExternalTrigConv = ADC_SOFTWARE_START;
  hadc.Init.DMAContinuousRequests = DISABLE;
  hadc.Init.EOCSelection = ADC_EOC_SINGLE_CONV;
  hadc.Init.Overrun = ADC_OVR_DATA_PRESERVED;
  hadc.Init.LowPowerAutoWait = DISABLE;
  hadc.Init.LowPowerFrequencyMode = DISABLE;
  hadc.Init.LowPowerAutoPowerOff = DISABLE;
  if (HAL_ADC_Init(&hadc) != HAL_OK)
  {
    Error_Handler();
  }

  /** Configure for the selected ADC regular channel to be converted.
  */
  sConfig.Channel = ADC_CHANNEL_0;
  sConfig.Rank = ADC_RANK_CHANNEL_NUMBER;
  if (HAL_ADC_ConfigChannel(&hadc, &sConfig) != HAL_OK)
  {
    Error_Handler();
  }
}

void HAL_ADC_MspInit(ADC_HandleTypeDef* adcHandle)
{

  GPIO_InitTypeDef GPIO_InitStruct = {0};
  if(adcHandle->Instance==ADC1)
  {
    /* ADC1 clock enable */
    __HAL_RCC_ADC1_CLK_ENABLE();

    __HAL_RCC_GPIOA_CLK_ENABLE();
    /**ADC GPIO Configuration
    PA0     ------> ADC_IN0
    */
    GPIO_InitStruct.Pin = GPIO_PIN_0;
    GPIO_InitStruct.Mode = GPIO_MODE_ANALOG;
    GPIO_InitStruct.Pull = GPIO_NOPULL;
    HAL_GPIO_Init(GPIOA, &GPIO_InitStruct);

    /* ADC1 interrupt Init */
    HAL_NVIC_SetPriority(ADC1_COMP_IRQn, 3, 0);
    HAL_NVIC_EnableIRQ(ADC1_COMP_IRQn);
  }
}

void HAL_ADC_MspDeInit(ADC_HandleTypeDef* adcHandle)
{

  if(adcHandle->Instance==ADC1)
  {
    /* Peripheral clock disable */
    __HAL_RCC_ADC1_CLK_DISABLE();

    /**ADC GPIO Configuration
    PA0     ------> ADC_IN0
    */
    HAL_GPIO_DeInit(GPIOA, GPIO_PIN_0);

    /* ADC1 interrupt Deinit */
    HAL_NVIC_DisableIRQ(ADC1_COMP_IRQn);
  }
}

/* USER CODE BEGIN 1 */
/**
  * @brief  Conversion complete callback in non-blocking mode.
  * @param  hadc ADC handle
  * @retval None
  */
void HAL_ADC_ConvCpltCallback(ADC_HandleTypeDef* hadc)
{
    adc.value[adc.times++] = HAL_ADC_GetValue(hadc);
    adc.refresh = true;
}

void adc_detect(void)
{
    MX_ADC_Init();
    memset(&adc, 0, sizeof(adc));
    HAL_ADC_Start_IT(&hadc);

    while (adc.times < 10)
    {
        LL_IWDG_ReloadCounter(IWDG);

        if (adc.refresh == true)
        {
            rfid_printf("refresh adc value:%d, %d, %f,in %f s\r\n", adc.times - 1, adc.value[adc.times - 1], adc.value[adc.times - 1] / 4096.0 * 3.0, HAL_GetTick() / 1000.0);
            adc.refresh = false;
            HAL_Delay(1);
            HAL_ADC_Start_IT(&hadc);
        }
    }

    adc.avgValue = (adc.value[0] + adc.value[1] + adc.value[2] + adc.value[3] + adc.value[4] + adc.value[5] + adc.value[6] + adc.value[7] + adc.value[8] + adc.value[9]) / 10;
    rfid_printf("avgValue:%d\n", adc.avgValue);

    if (HAL_ADC_DeInit(&hadc) != HAL_OK)
    {
        Error_Handler();
    }
}

/* USER CODE END 1 */
