phoenix9668/RFID_CC1101_433MHz_V2/Core/Src/no_os_alloc.c

#include "no_os_alloc.h"

void *no_os_malloc(size_t size)
{
    return malloc(size);
}

void *no_os_calloc(size_t nitems, size_t size)
{
    return calloc(nitems, size);
}

void no_os_free(void *ptr)
{
    free(ptr);
}
