phoenix9668/RFID_CC1101_433MHz_V2/Core/Inc/gpio.h

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
/* Define to prevent recursive inclusion -------------------------------------*/
#ifndef __GPIO_H__
#define __GPIO_H__

#ifdef __cplusplus
extern "C" {
#endif

/* Includes ------------------------------------------------------------------*/
#include "main.h"

/* USER CODE BEGIN Private defines */
#define LED_GREEN_OFF()				HAL_GPIO_WritePin(LED_GREEN_GPIO_Port, LED_GREEN_Pin, GPIO_PIN_RESET)
#define LED_GREEN_ON()				HAL_GPIO_WritePin(LED_GREEN_GPIO_Port, LED_GREEN_Pin, GPIO_PIN_SET)
#define LED_GREEN_TOG()				HAL_GPIO_TogglePin(LED_GREEN_GPIO_Port, LED_GREEN_Pin)

#define CC1101_POWER_DOWN()		HAL_GPIO_WritePin(PB5_GPIO_Port, PB5_Pin, GPIO_PIN_RESET)
#define CC1101_POWER_ON()		  HAL_GPIO_WritePin(PB5_GPIO_Port, PB5_Pin, GPIO_PIN_SET)
#define TX_EN_LOW()			      HAL_GPIO_WritePin(TX_EN_GPIO_Port, TX_EN_Pin, GPIO_PIN_RESET)
#define TX_EN_HIGH()			    HAL_GPIO_WritePin(TX_EN_GPIO_Port, TX_EN_Pin, GPIO_PIN_SET)
#define RX_EN_LOW()			      HAL_GPIO_WritePin(RX_EN_GPIO_Port, RX_EN_Pin, GPIO_PIN_RESET)
#define RX_EN_HIGH()		      HAL_GPIO_WritePin(RX_EN_GPIO_Port, RX_EN_Pin, GPIO_PIN_SET)

#define CC1101_CSN_LOW()			HAL_GPIO_WritePin(SPI1_CS_GPIO_Port, SPI1_CS_Pin, GPIO_PIN_RESET)
#define CC1101_CSN_HIGH()			HAL_GPIO_WritePin(SPI1_CS_GPIO_Port, SPI1_CS_Pin, GPIO_PIN_SET)
#define ADXL362_CSN_LOW()			HAL_GPIO_WritePin(SPI2_CS_GPIO_Port, SPI2_CS_Pin, GPIO_PIN_RESET)
#define ADXL362_CSN_HIGH()		HAL_GPIO_WritePin(SPI2_CS_GPIO_Port, SPI2_CS_Pin, GPIO_PIN_SET)

#define CC1101_MISO_READ()		HAL_GPIO_ReadPin(GPIOA, LL_GPIO_PIN_6)

/* USER CODE END Private defines */

void MX_GPIO_Init(void);

#ifdef __cplusplus
}
#endif
#endif /*__ GPIO_H__ */
