phoenix9668/RFID_CC1101_433MHz_V2/(commit log)

2021-08-10 update PCB
    update RFID_CC1101_433MHz PCB documents.
    [MCU.SchDoc, MEMS&RF.SchDoc, Power.SchDoc, RFID_CC1101_433MHz.PcbDoc, RFID_CC1101_433MHz.PcbLib, RFID_CC1101_433MHz.PrjPcb, RFID_CC1101_433MHz.SchDoc, RFID_CC1101_433MHz.SchLib]
2021-08-23 update PCB Ver2.2
    [MCU.SchDoc, Power.SchDoc, RFID_CC1101_433MHz.PcbDoc, RFID_CC1101_433MHz.PcbLib, RFID_CC1101_433MHz.PrjPcb, RFID_CC1101_433MHz.SchLib, RFID_CC1101_433MHz.xls]
2021-09-07 修复日历时间的通信BUG
    1.添加生产相关的合同；
    2.配置日历时间的通信有bug，将HAL_Delay(2)改为HAL_Delay(4)后正常，即时序有问题；
    [RFID_CC1101_433MHz_BOM_配件.xls, 联保-国科蓝海合同210826.xlsx]
2021-09-10 update PCB Ver2.3
    1.update PCB Ver2.3;
    2.add Doc, include Purchase Contract and Production Process
    [MCU.SchDoc, MEMS&RF.SchDoc, Power.SchDoc, RFID_CC1101_433MHz(2021.8.24).xls, RFID_CC1101_433MHz.PcbDoc, RFID_CC1101_433MHz.PcbLib, RFID_CC1101_433MHz.PrjPcb, RFID_CC1101_433MHz.SchLib]
2021-09-13 update program adapted to PCB Ver2.3
    1.update program adapted to PCB Ver2.3,include LSI change to LSE and HSI change to HSE.
    2.update DeviceWriteExcelTools.exe and 《RFID_CC1101_433MHz_V2生产组装流程》
    [联保-国科蓝海合同210913.xlsx]
2022-01-11 upgrade product document
    1.更新《RFID项圈产品编号(2021.10.28).xlsx》；
    2.更新《RFID_CC1101_433MHz_配件.xls》;
    [RFID_CC1101_433MHz_BOM_配件.xls, RFID_CC1101_433MHz_配件.xls, RFID项圈产品编号(2021.10.28).xlsx, RFID项圈产品编号.xlsx]
2022-01-14 resolve cc1101 send error
    1.debug CC1101Reset() according to the datasheet;
    2.WOR mode to TX mode must be through IDLE mode first;
    [config.txt]
2022-01-21 complete cc1101 Variable packet length mode and add crc32
    1.complete cc1101 Variable packet length mode，send packet length < 256 can work;
    2.add CRC module and complete crc logic；
2022-01-26 modify crc32 calculate for 4-bytes alignment
    1.modify crc32 calculate for 4-bytes alignment；
    2.no battery power monitoring；
2022-02-10 add random bytes generator function
    1.add random bytes generator function，use STM32CubeExpansion_Crypto_V3.1.0 library；
    2.add 32 random bytes in protocol;
    3.change send period to one hour;
    [RFID_CC1101_433MHz_配件(2022.2.9).xls]
2022-03-14 set inactive time equip 16/200s
    1.set inactive time equip 16/200s;
    2.add purchase list;
    [RFID_CC1101_433MHz_天线(2022.2.14).xls, RFID_CC1101_433MHz_电源(2022.2.14).xls]
2022-03-18 update PCB Ver3.0
    1.update PCB Ver3.0;
    2.delete Purchase Contract document purchase file;
    [EQ for RFID_CC1101_433MHz（s291495h04a0）1238.xls, MCU.SchDoc, MEMS&RF.SchDoc, Power.SchDoc, RFID_CC1101_433MHz(2021.8.24).xls, RFID_CC1101_433MHz(2022.2.16).xlsx, RFID_CC1101_433MHz.PcbDoc, RFID_CC1101_433MHz.PcbLib]
2022-03-20 upgrade project for PCB Ver3.0
    add LED1,LED2 GPIO;
2022-03-21 add adc sample function
    1.add adc sample function;
    2.add TX_EN,RX_EN GPIO function;
    3.change crc logic, delete uLen logic.
2022-03-28 add reset count logic
    1.add reset count logic;
    2.send reset count through cc1101.
    [cc1101.h, main.c]
2022-04-01 configure adxl362 fifo triggered mode and use fifo overrun interrupt
    1.upgrade adxl362 fifo logic:configure adxl362 fifo triggered mode and use fifo overrun interrupt;
    2.read all fifo data for post-processing;
    3.delete free fall detect logic;
    [origin_data.xlsx]
2022-04-25 Standby power consumption optimization
    1.Standby power consumption is ~70uA;
    2.Send three-axis accelerated raw data.
    [example_data.xlsx, origin_data.xlsx]
2022-06-02 stopmode has bug!!!
    1.change step and ingestion algorithms;
    2.delete ltpim;
    3.chang rtc interrupt logic and main,c, then stop mode occur bug that once cc1101 send over, the stop mode power consumption come up to 8mA. The cause was not found.
    [caishi(2022.4.29.12)5min_tou_44.30_45.59(down2up)_output.xlsx, caishi(2022.4.29.12)5min_tou_45.59_46.22(up2down)_output.xlsx, caishi(2022.4.29.12)5min_tou_46.22_48.21_output.xlsx, origin_data(2022.4.27.15)tou.xlsx, origin_data(2022.4.27.15)tui.xlsx, origin_data(2022.4.27.17)tou.xlsx, origin_data(2022.4.27.17)tui.xlsx, origin_data(2022.4.28.1)tou.xlsx]
2022-06-07 debug the stopmode bug
    1.delete usart.rxState == RESET in main.c;
    2.add CC1101_GDO_Init() and CC1101_GDO_DeInit() functions;
    [RFID_CC1101_433MHz_V2.ioc, adc.c, cc1101.h, main.c, main.h, rtc.c]
2022-06-08 update PCB Ver3.1 and download version 3.1
    1.update PCB Ver3.1;
    2.add delayRand variable and random delay logic;
    3.download version 3.1.
    [EQ for RFID_CC1101_433MHz（s291495h04a0）1238.xls, MCU.SchDoc, MEMS&RF.SchDoc, Power.SchDoc, RFID_CC1101_433MHz(2022.2.16).xlsx, RFID_CC1101_433MHz(2022.4.8).xlsx, RFID_CC1101_433MHz.PcbDoc, RFID_CC1101_433MHz.PcbLib]
2022-08-15 modify rtc.tenSecTick logic
    modify if(rtc.tenSecTick == 120) to if(rtc.tenSecTick >= 120）
    [caishi(2022.4.29.12)5min_tou_44.30_45.59(down2up)_output.xlsx, caishi(2022.4.29.12)5min_tou_46.22_48.21_output.xlsx, origin_data(2022.4.28.1)tou.xlsx, xingzou(2022.4.29.12)4min_tou_output.xlsx]
2023-03-07 xu 2023.3.7 version for PCB Ver3.1
    [18650耐低温锂电池(2022.11.1).xls, 3D打印机(2022.11.18).xls, caishi(2022.4.29.12)5min_tou_44.30_45.59(down2up)_output.xlsx, caishi(2022.4.29.12)5min_tou_45.59_46.22(up2down)_output.xlsx, caishi(2022.4.29.12)5min_tou_46.22_48.21_output.xlsx, origin_data(2022.4.27.17)tou.xlsx, origin_data(2022.4.28.1)tou.xlsx, vofa_9.15.11.xlsx]
2023-03-07 update PCB Ver3.2 and use voft+ software to test
    1.update PCB Ver3.2;
    2.send three axis data to voft+ software for test.
    [EQ for RFID_CC1101_433MHz（s291495h04a0）1238.xls, MCU.SchDoc, MEMS&RF.SchDoc, Power.SchDoc, RFID_CC1101_433MHz(2022.4.8).xlsx, RFID_CC1101_433MHz.PcbDoc, RFID_CC1101_433MHz.PrjPcb, RFID_CC1101_433MHz.SchDoc]
2023-04-11 delete movement array not zero logic
    1.delete movement array not zero logic；
    2.recover CC1101_POWER_ON and CC1101_POWER_DOWN module；
    3.recover adc.avgValue logic.
2023-04-17 use MSK register configure
    use MSK register configure，test transfer length
2023-04-25 add gitignore
    [example_data.xlsx, origin_data(2022.4.27.15)tou.xlsx, origin_data(2022.4.27.15)tui.xlsx, origin_data(2022.4.27.17)tou.xlsx, origin_data(2022.4.27.17)tui.xlsx, origin_data(2022.4.28.1)tou.xlsx, origin_data(2022.4.28.2)tou.xlsx, origin_data(2022.4.28.3)tou.xlsx]
2023-05-04 xu 2023.4.25 version
    open x axis and z axis data.
2023-05-22 main axis change y axis to x axis
    1.main axis change y axis to x axis；
    2.delete send three times logic.
2023-06-27 add doc
    《RFID_CC1101_433MHz_V3.3(2023.6.15)500个项圈 .xls》
    [RFID_CC1101_433MHz_V3.3(2023.6.15)500个项圈 .xls]
2023-08-09 upload some documents
    upload some documents
    [带镍片18650耐低温锂电池(2023.4.26).xls, 环氧胶和NFC(2023.7.12) .xls]
2023-09-05 upload some purchase documents
    upload some purchase documents
    [RFID_CC1101_433MHz_V3.3(2023.6.15)500个项圈 .xls, 环氧胶(2023.9.1).xls, 环氧胶和NFC(2023.7.12) .xls]
2024-08-07 upgrade firmware
    1.upgrade firmware；
    2.upload some purchase documents.
    [RFID_CC1101_433MHz_V3.3(2023.11.10)项圈生产BOM.xls, RFID_CC1101_433MHz_V3.3(2023.6.15)500个项圈 .xls, RFID_CC1101_433MHz_V3.3(2024.3.26)项圈生产BOM(1000套).xls, RFID_CC1101_433MHz_V3.3(2024.3.27)项圈生产BOM.xls]
2025-05-07 上传《PCB板载天线问题总结.docx》
    adxl362.c和adxl362.h使用vscode格式化
    [频谱分析仪.xls]
2025-05-09 添加重度喘息逻辑，将other字段分配为重度喘息
2026-06-24 Prepare ADXL362 Windows handoff
    [02 1004 20230315 1819-2219 29W.csv, 0A07基站 标题 - 喘息1.csv, DTK LoRa模块采购.xls, RFID_CC1101_433MHz_V3.3(2024.3.26)项圈生产BOM(1000套).xls, RFID_CC1101_433MHz_V3.3(2024.3.27)项圈生产BOM.xls, RFID_CC1101_433MHz_配件.xls, chuanxi.csv, chuanxi_with_behavior.csv]
2026-06-24 using cmake toolchain
    [VIC0250B.STEP]
2026-06-24 refactor: migrate ADXL362 to ADI no-OS driver
    Import the Analog Devices no-OS ADXL362 driver snapshot pinned to commit 0c4ef5cd278555ba4d426b35f87f30102460361f and document the vendored source location.
    Split the project ADXL362 integration so adxl362_app.c owns official-driver initialization, register wrappers, configuration readback, and FIFO reads, while adxl362_behavior.c keeps the existing FIFO parsing and behavior classification logic for firmware and the PC regression runner.
    Add minimal no-OS compatibility layers for STM32L0 LL SPI2 and allocation. The SPI adapter wraps full-duplex transfers with ADXL362 chip-select handling and timeout-bounded polling, replacing the previous firmw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
2026-09-04 docs: 归档 V3.8 合同文件
2026-09-04 feat: 拆分 CC1101 驱动并加入喘息验证
    [05项圈 5826牛 0302 1549 反刍.csv, 喘息20250819 1622.csv, 喘息20250820 1644.csv, 喘息20250820 1755.csv]
2026-09-21 chore: configure GPT-6 Astra workflow and validation baseline
    Pin gpt-6-astra with high reasoning in project-local Codex configuration,
    preserving the existing user-level model choice. Add AGENTS.md with the
    STM32L051 toolchain, HAL/LL boundaries, driver ownership, protocol invariants,
    and scoped validation guidance.
    Unblock native Windows behavior verification by adding a MinGW-compatible
    line reader to the PC runner. Keep POSIX getline and production firmware
    unchanged. Cover empty input, CRLF, blank and long lines, buffer reuse and
    EOF without a final newline; retain checks in NDEBUG builds. Document native
    PowerShell builds and the ASCII-path workaround for older MinGW runtimes.
    Record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
    [main.c, pc_getline.h]
2026-09-21 update:pcb v3.8
    [BOM_RFID_CC1101_433MHz(2025.8.18)_RFID_CC1101_433MHz(2025.8.18)_2026-09-21.xlsx, PickAndPlace_RFID_CC1101_433MHz_2025_8_18__2026_09_21.xlsx]
