phoenix9668/RFID_CC1101_433MHz_V2/(notices)

Notices in the files:
Core/Src/spi.c:
Copyright (c) 2022 STMicroelectronics.
All rights reserved.
This software is licensed under terms that can be found in the LICENSE file
Core/Inc/main.h:
© Copyright (c) 2020 STMicroelectronics.
This software component is licensed by ST under BSD 3-Clause license,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
